ac-ctrl/Medtronic-PB560-Ventilator-System/BOM Drawings/PB560 Ventilator/10040465B00.pdf

PPB560 Volume and Pressure Tests Manufacturing Test Specification Document Number, 10040465 Rev B

Nellcor Puritan Bennett Ireland Ltd. Confidential | Page 1 of 9

# Manufacturing Test Specification Volume and Pressure Tests

PB560

PB560 Volume and Pressure Tests

Nellcor Puritan Bennett Ireland Ltd. Confidential | Page 2 of 9

## Revision History

Revision | Change Order | Author | Approval by | Approval Date | Summary of Change
X1 | ECO-R178940 | | See Agile | See Agile | Initial Draft Release
A | ECO-R182740 | | See Agile | See Agile | Release to Rev A
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
