ac-ctrl/Medtronic-PB560-Ventilator-System/BOM Drawings/PB560 PowerPack/10106052C00/MOLEX 52207-1960.SLDASM

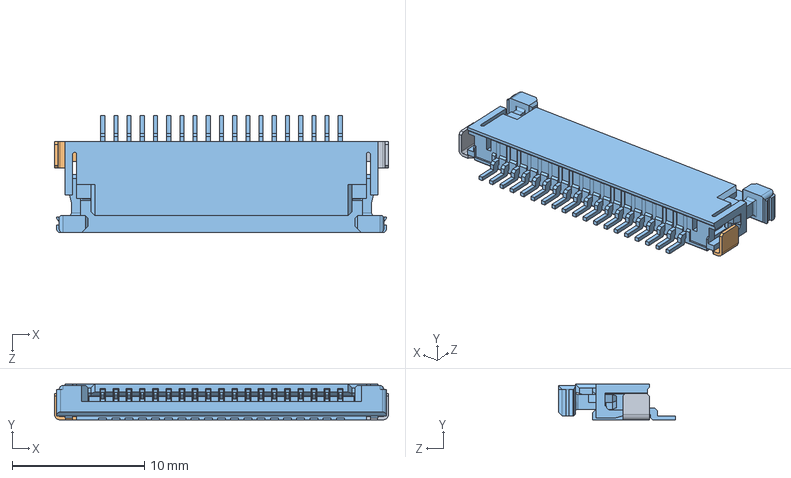
[picture p11: CAD file, 2020-04-08]
BOM Drawings/PB560 PowerPack/10106052C00/MOLEX 52207-1960.SLDASM
25.3 x 2.70 x 8.90 mm
