ac-ctrl/Medtronic-PB560-Ventilator-System/3D CAD Models/alimentation xp.sldasm

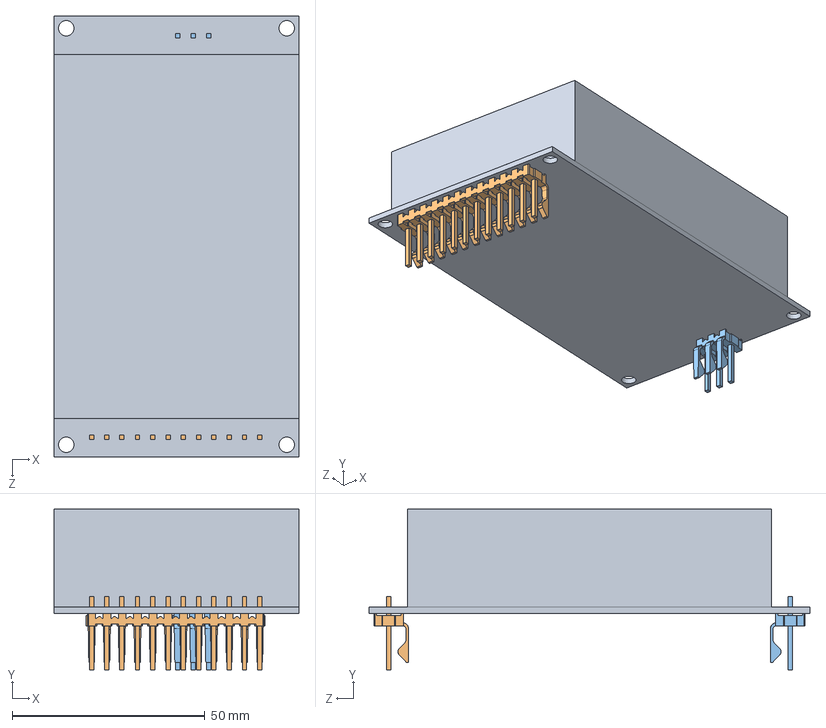
[picture p12: CAD file, 2020-03-31]
3D CAD Models/alimentation xp.sldasm
63.5 x 41.7 x 114.3 mm
alimentation phase 2
