ac-ctrl/Medtronic-PB560-Ventilator-System/3D CAD Models/Batt PCB Assy.SLDASM

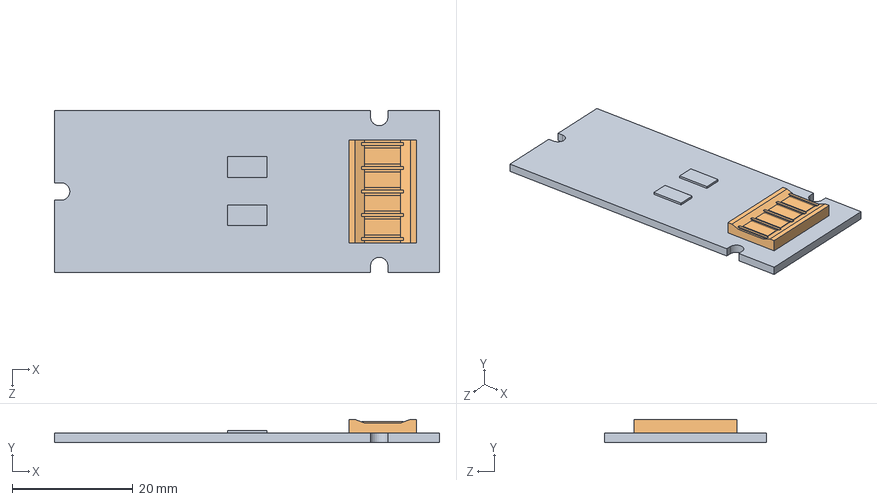
[picture p13: CAD file, 2020-03-31]
3D CAD Models/Batt PCB Assy.SLDASM
63.9 x 3.85 x 26.9 mm
Batt PCB
Batt Contacts tab
