ac-ctrl/Medtronic-PB560-Ventilator-System/3D CAD Models/valve chiprop.SLDASM

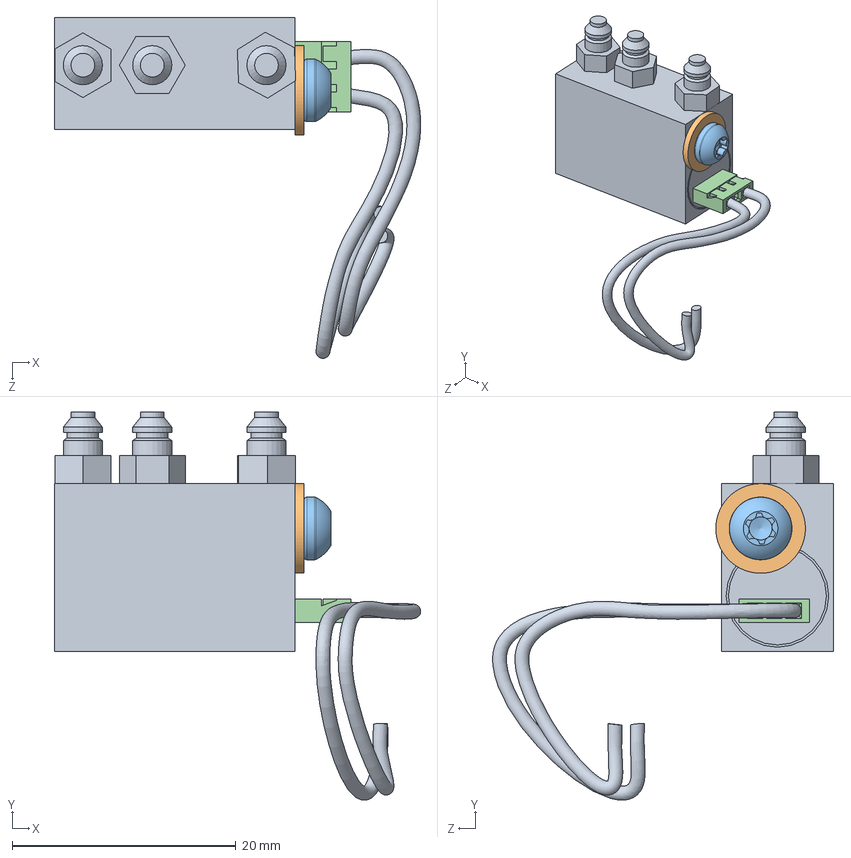
[picture p14: CAD file, 2020-03-31]
3D CAD Models/valve chiprop.SLDASM
32.7 x 34.7 x 30.4 mm
valve chiprop
2004200 Rondelle plate - MN INOX 3 x 8 EP 0.8
2966100 Vis TCB M3 x 5 exalobes acier zingué
Exh Valve connector
