ac-ctrl/Medtronic-PB560-Ventilator-System/3D CAD Models/Batt Assy.SLDASM

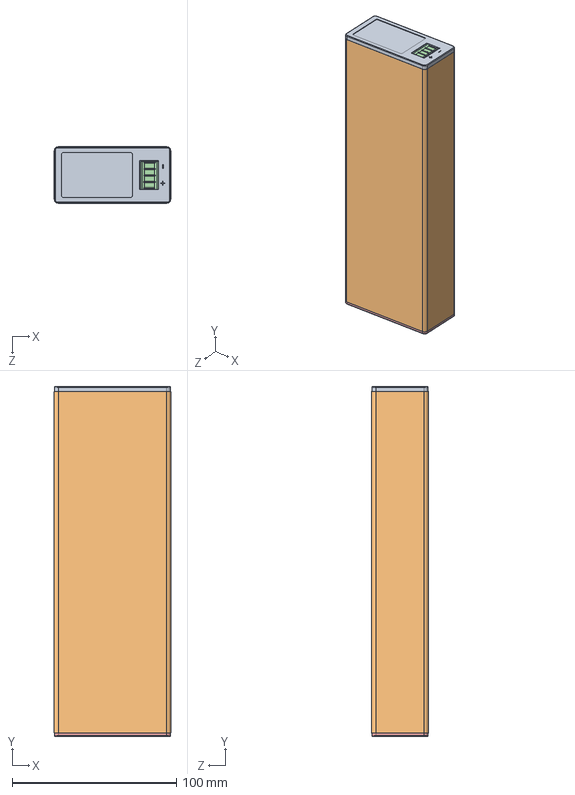
[picture p15: CAD file, 2020-03-31]
3D CAD Models/Batt Assy.SLDASM
71.0 x 213.0 x 34.5 mm
Front End Cap
Extruded housing
Batt PCB
Batt Contacts tab
Back End Cap
