ac-ctrl/Medtronic-PB560-Ventilator-System/3D CAD Models/tuyau 15x21 silicone.SLDPRT

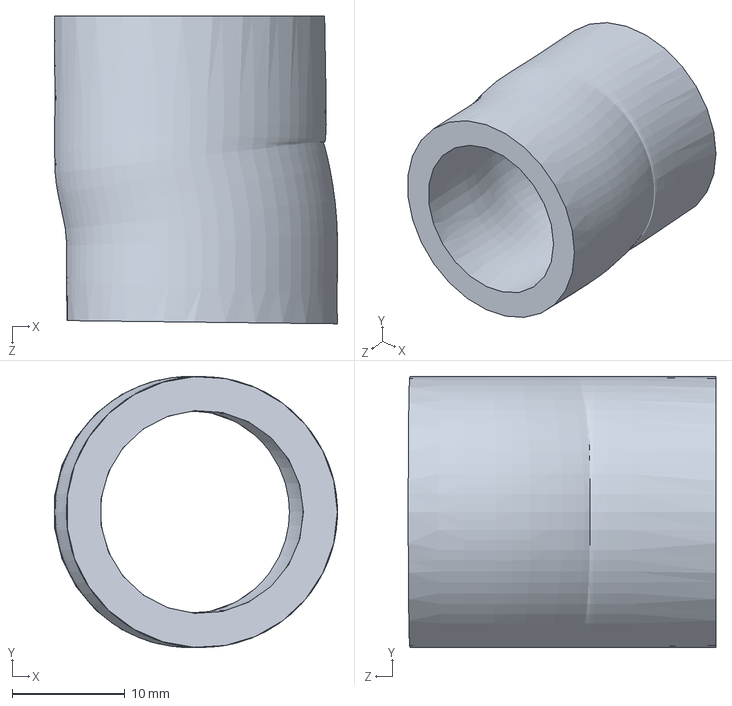
[picture p16: CAD file, 2020-03-31]
3D CAD Models/tuyau 15x21 silicone.SLDPRT
25.1 x 24.0 x 27.2 mm
