ac-ctrl/Medtronic-PB560-Ventilator-System/BOM Drawings/PB560 PowerPack/10109799A00/2-520129-2.SLDPRT

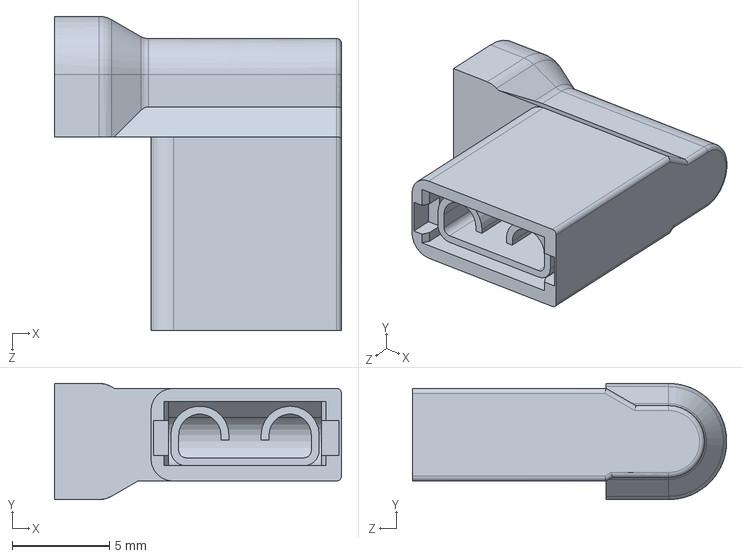
[picture p17: CAD file, 2020-04-08]
BOM Drawings/PB560 PowerPack/10109799A00/2-520129-2.SLDPRT
14.7 x 5.97 x 16.1 mm
