ac-ctrl/Medtronic-PB560-Ventilator-System/BOM Drawings/PB560 PowerPack/10109800A00/TE 62109-2.SLDPRT

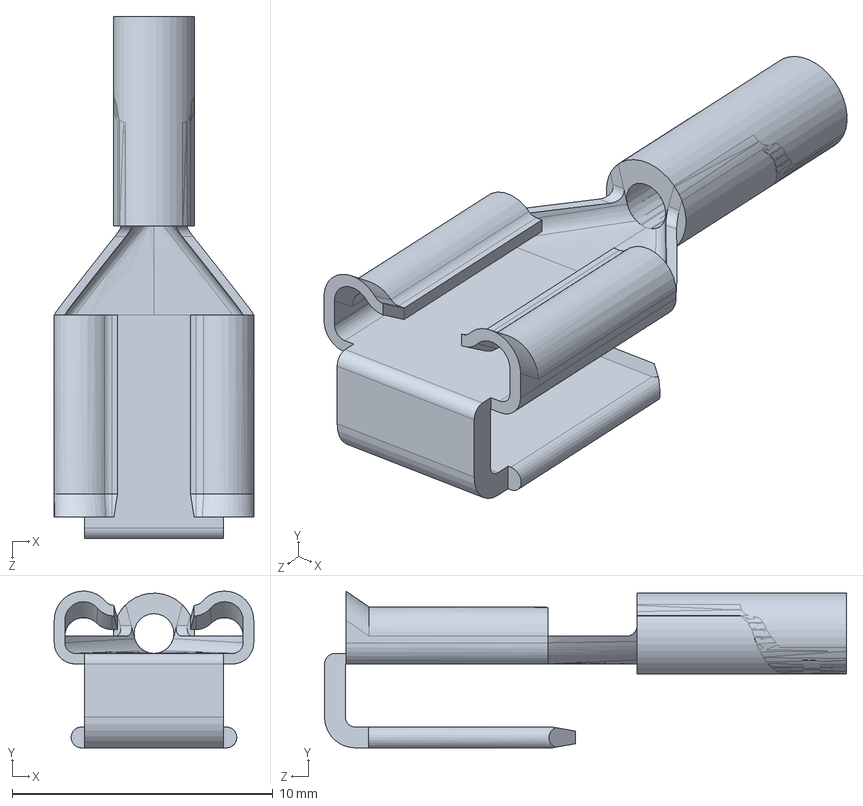
[picture p18: CAD file, 2020-04-08]
BOM Drawings/PB560 PowerPack/10109800A00/TE 62109-2.SLDPRT
7.65 x 6.01 x 20.0 mm
