ac-ctrl/Medtronic-PB560-Ventilator-System/BOM Drawings/PB560 PowerPack/10109802B00/Switchcraft 761KS15 Terminals.SLDPRT

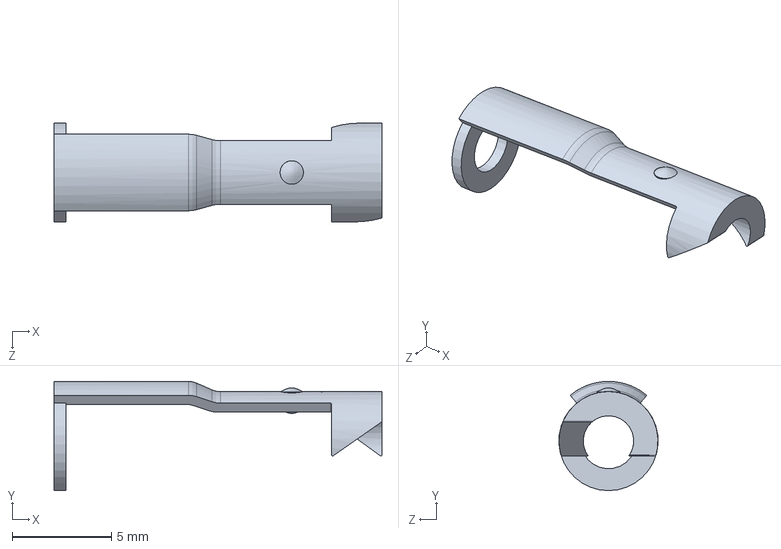
[picture p19: CAD file, 2020-04-08]
BOM Drawings/PB560 PowerPack/10109802B00/Switchcraft 761KS15 Terminals.SLDPRT
16.5 x 5.50 x 4.99 mm
