ac-ctrl/Medtronic-PB560-Ventilator-System/BOM Drawings/PB560 PowerPack/10109797A00/HS Label.SLDPRT

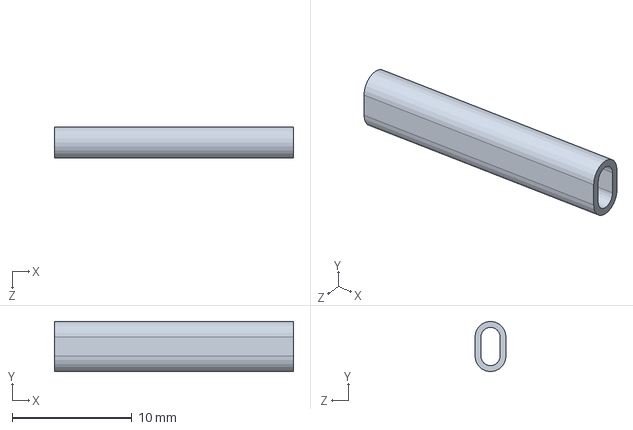
[picture p21: CAD file, 2020-04-08]
BOM Drawings/PB560 PowerPack/10109797A00/HS Label.SLDPRT
20.0 x 4.20 x 2.60 mm
