ac-ctrl/Medtronic-PB560-Ventilator-System/BOM Drawings/PB560 PowerPack/10109801A00/Socket_Switchcraft L712AS.SLDPRT

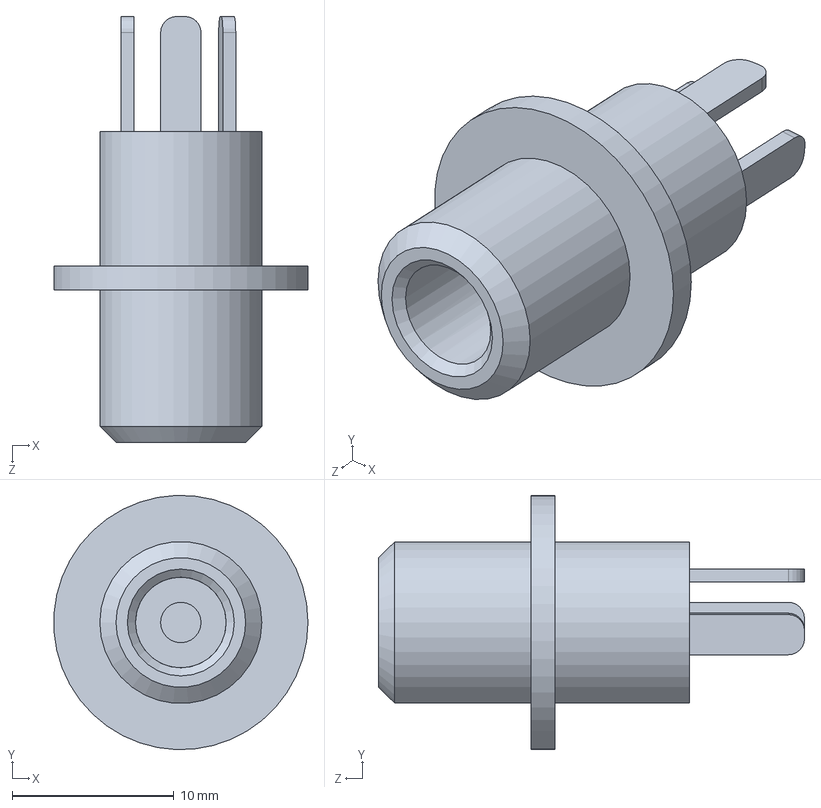
[picture p22: CAD file, 2020-04-08]
BOM Drawings/PB560 PowerPack/10109801A00/Socket_Switchcraft L712AS.SLDPRT
15.7 x 15.7 x 26.3 mm
