ac-ctrl/Medtronic-PB560-Ventilator-System/BOM Drawings/PB560 PowerPack/10113688A00/2-520336-2.SLDPRT

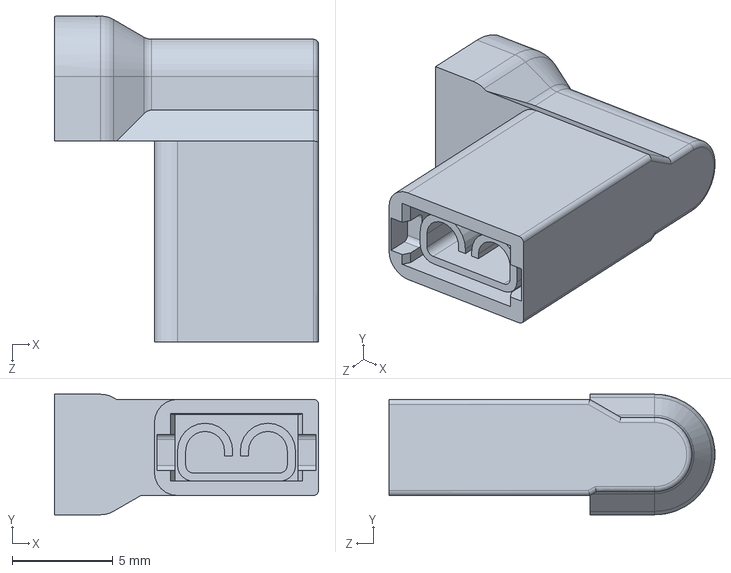
[picture p23: CAD file, 2020-04-08]
BOM Drawings/PB560 PowerPack/10113688A00/2-520336-2.SLDPRT
13.1 x 5.97 x 16.1 mm
