ac-ctrl/Medtronic-PB560-Ventilator-System/BOM Drawings/PB560 Ventilator/10096510/10096506/10096506A00/10096506A00/per.dxf

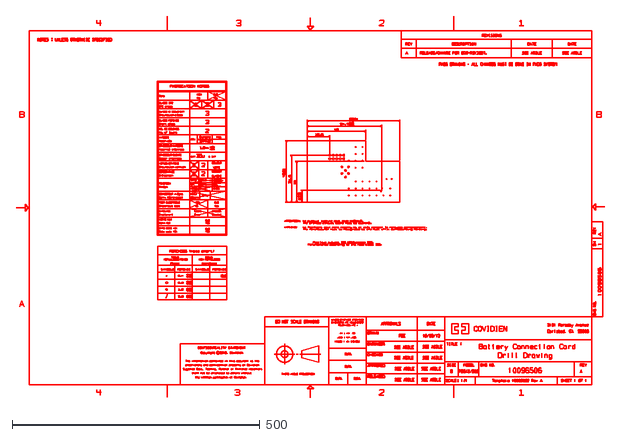
[picture p24: CAD file, 2020-04-08]
BOM Drawings/PB560 Ventilator/10096510/10096506/10096506A00/10096506A00/per.dxf
1188.1 x 770.1
