ac-ctrl/Medtronic-PB560-Ventilator-System/3D CAD Models/entretoise hexa  m3x8.SLDPRT

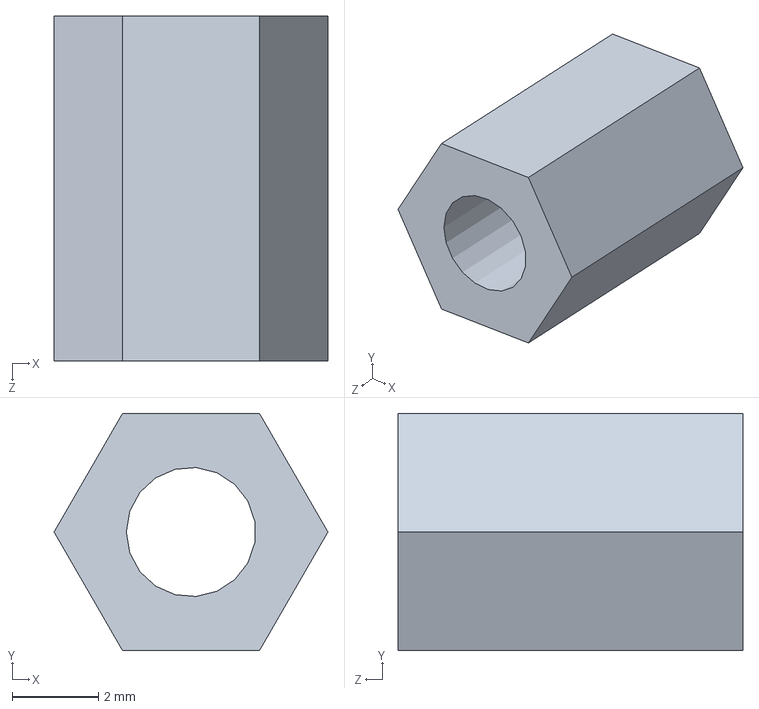
[picture p25: CAD file, 2020-03-31]
3D CAD Models/entretoise hexa m3x8.SLDPRT
6.35 x 5.50 x 8.00 mm
