ac-ctrl/Medtronic-PB560-Ventilator-System/3D CAD Models/39-28-5264.SLDPRT

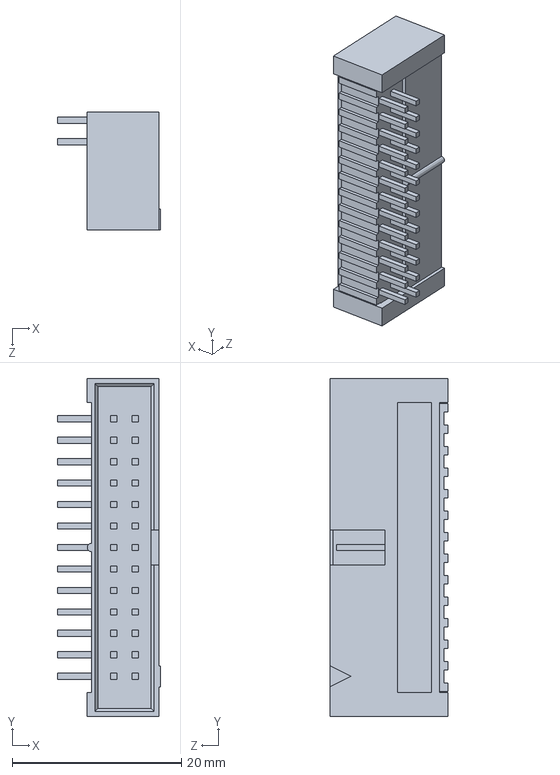
[picture p27: CAD file, 2020-03-31]
3D CAD Models/39-28-5264.SLDPRT
12.1 x 40.0 x 14.0 mm
