ac-ctrl/Medtronic-PB560-Ventilator-System/BOM Drawings/PB560 PowerPack/10106052C00/MOLEX 43650-0229.SLDPRT

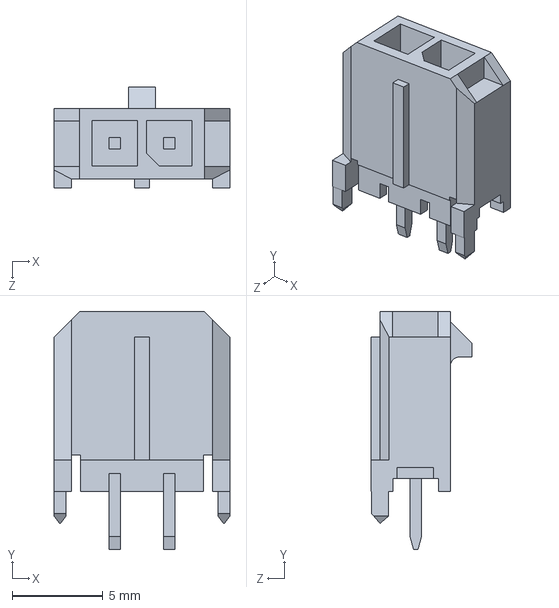
[picture p28: CAD file, 2020-04-08]
BOM Drawings/PB560 PowerPack/10106052C00/MOLEX 43650-0229.SLDPRT
9.65 x 13.1 x 5.57 mm
