ac-ctrl/Medtronic-PB560-Ventilator-System/BOM Drawings/PB560 PowerPack/10109802B00/WURTH 74270057.SLDPRT

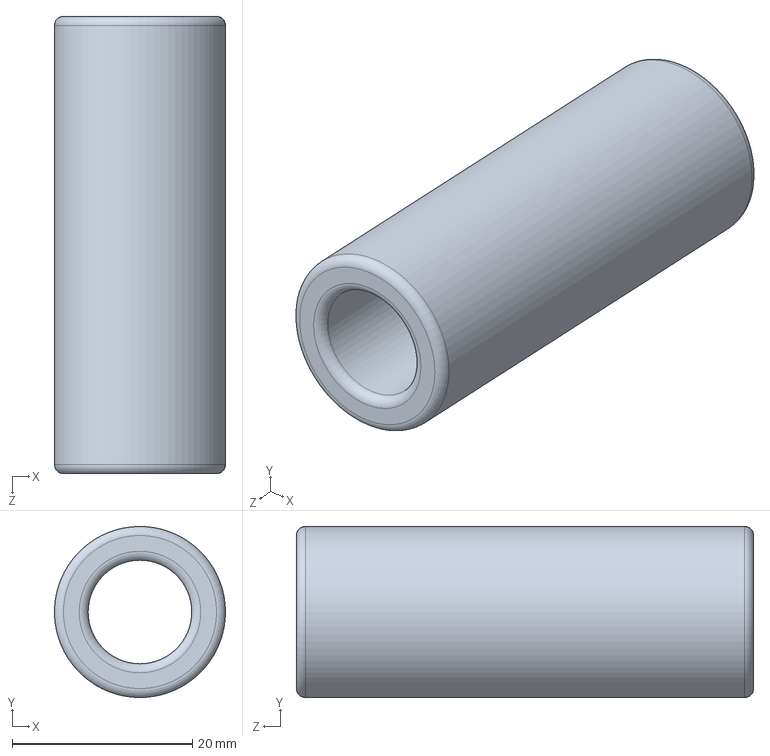
[picture p29: CAD file, 2020-04-08]
BOM Drawings/PB560 PowerPack/10109802B00/WURTH 74270057.SLDPRT
19.0 x 19.0 x 50.8 mm
