ac-ctrl/Medtronic-PB560-Ventilator-System/BOM Drawings/PB560 PowerPack/10110230A00 (1)/KerbKonus_307000030100.SLDPRT

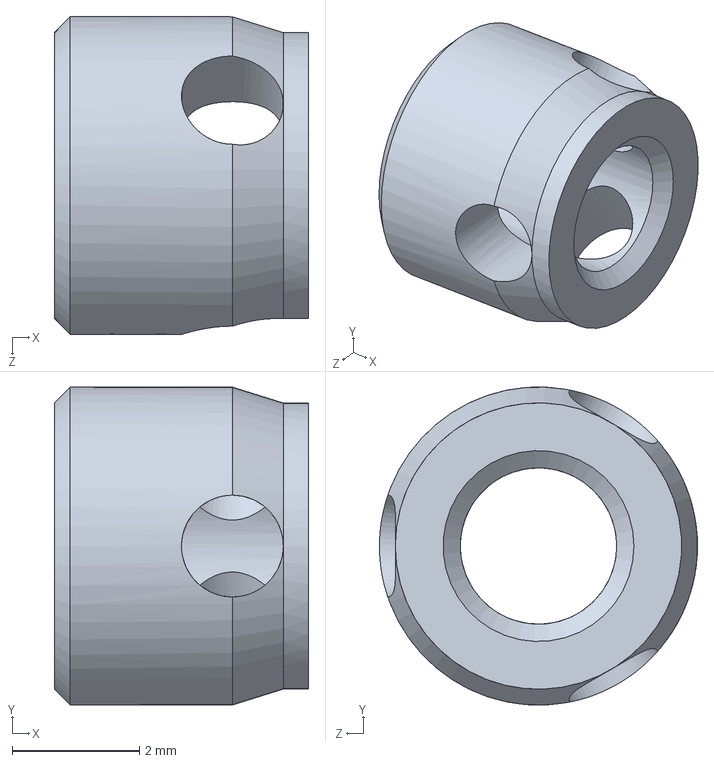
[picture p30: CAD file, 2020-04-08]
BOM Drawings/PB560 PowerPack/10110230A00 (1)/KerbKonus_307000030100.SLDPRT
4.00 x 5.00 x 5.00 mm
