ac-ctrl/Medtronic-PB560-Ventilator-System/3D CAD Models/PRECI-DIP 811-S1-002-30-014101.SLDPRT

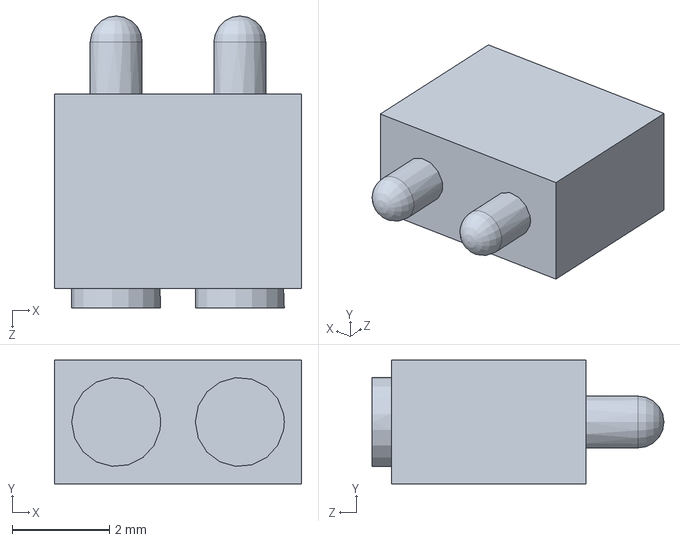
[picture p31: CAD file, 2020-03-31]
3D CAD Models/PRECI-DIP 811-S1-002-30-014101.SLDPRT
5.08 x 2.54 x 6.00 mm
