ac-ctrl/Medtronic-PB560-Ventilator-System/3D CAD Models/Joint blindage conducteur 72x21xép4.SLDPRT

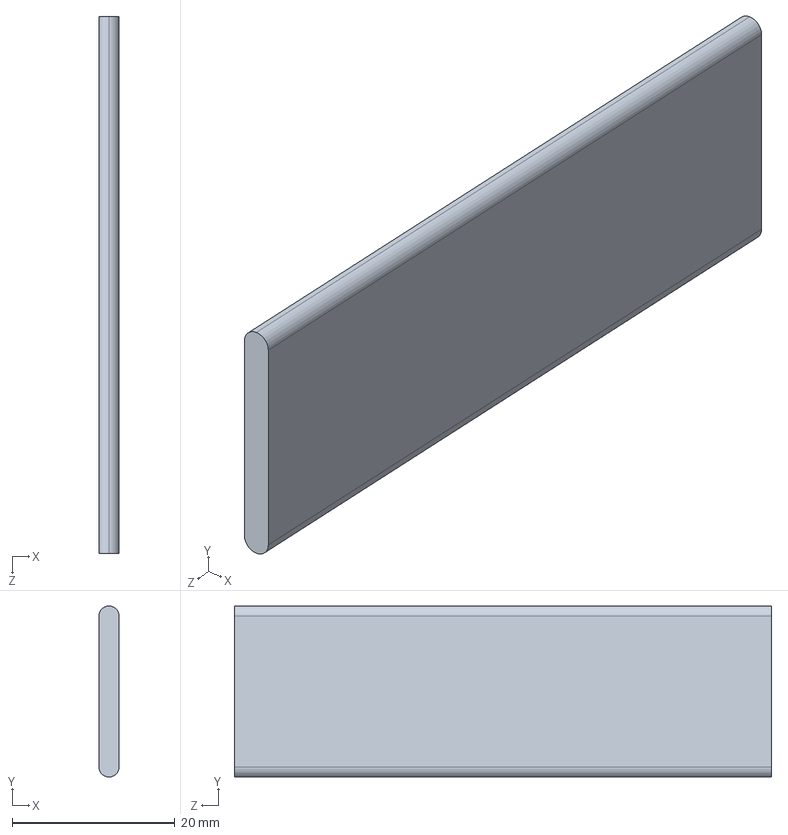
[picture p32: CAD file, 2020-03-31]
3D CAD Models/Joint blindage conducteur 72x21xép4.SLDPRT
2.50 x 21.0 x 66.0 mm
