ac-ctrl/Medtronic-PB560-Ventilator-System/3D CAD Models/HIROSE HR30-6R-6S.SLDPRT

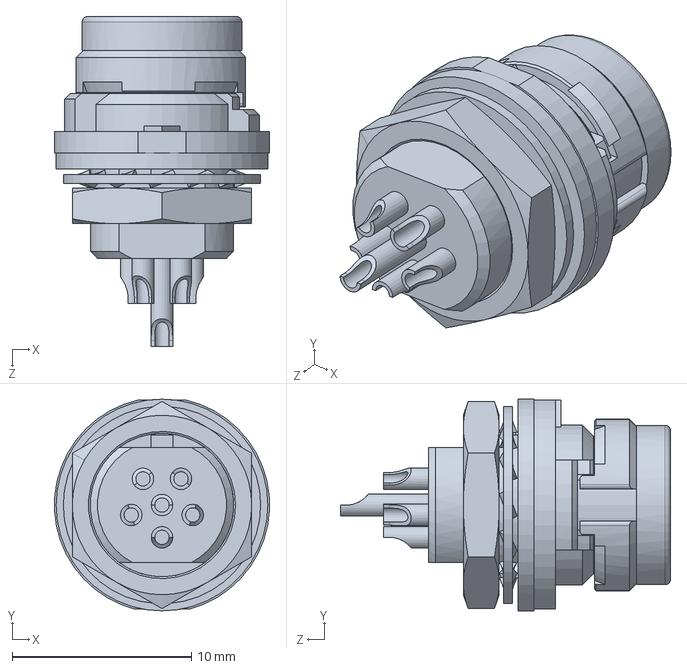
[picture p33: CAD file, 2020-03-31]
3D CAD Models/HIROSE HR30-6R-6S.SLDPRT
12.0 x 11.8 x 18.4 mm
