ac-ctrl/Medtronic-PB560-Ventilator-System/3D CAD Models/702-09 Entretoise AV Legendair.SLDPRT

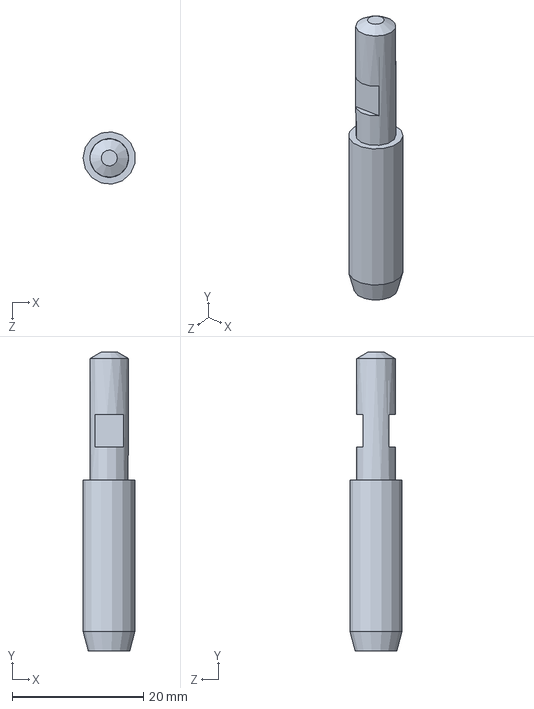
[picture p34: CAD file, 2020-03-31]
3D CAD Models/702-09 Entretoise AV Legendair.SLDPRT
7.91 x 45.5 x 7.96 mm
