ac-ctrl/Medtronic-PB560-Ventilator-System/3D CAD Models/1mm bumper.SLDPRT

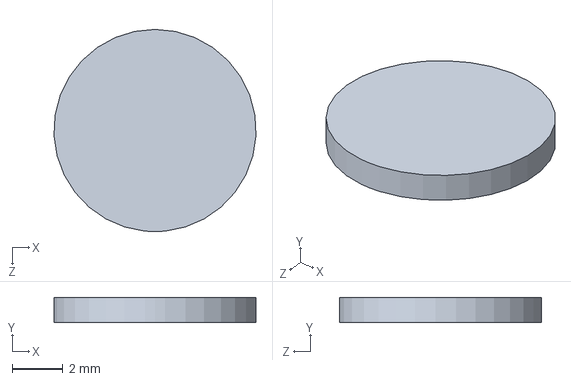
[picture p35: CAD file, 2020-03-31]
3D CAD Models/1mm bumper.SLDPRT
7.99 x 1.00 x 8.00 mm
