ac-ctrl/Medtronic-PB560-Ventilator-System/3D CAD Models/carte buzzer.SLDPRT

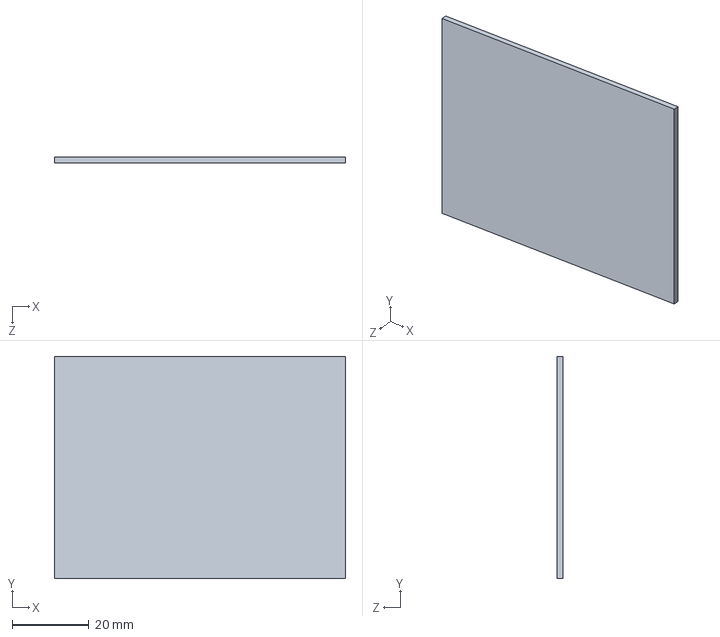
[picture p36: CAD file, 2020-03-31]
3D CAD Models/carte buzzer.SLDPRT
76.0 x 58.0 x 1.60 mm
