ac-ctrl/Medtronic-PB560-Ventilator-System/BOM Drawings/PB560 PowerPack/10106052C00/JST S2B-ZR-SM4A-TF.SLDPRT

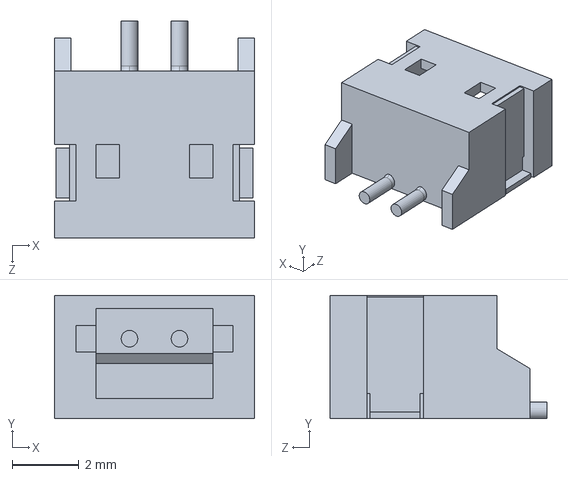
[picture p37: CAD file, 2020-04-08]
BOM Drawings/PB560 PowerPack/10106052C00/JST S2B-ZR-SM4A-TF.SLDPRT
6.00 x 3.70 x 6.50 mm
