ac-ctrl/Medtronic-PB560-Ventilator-System/BOM Drawings/PB560 PowerPack/10106052C00/MOLEX 02661-4020.SLDPRT

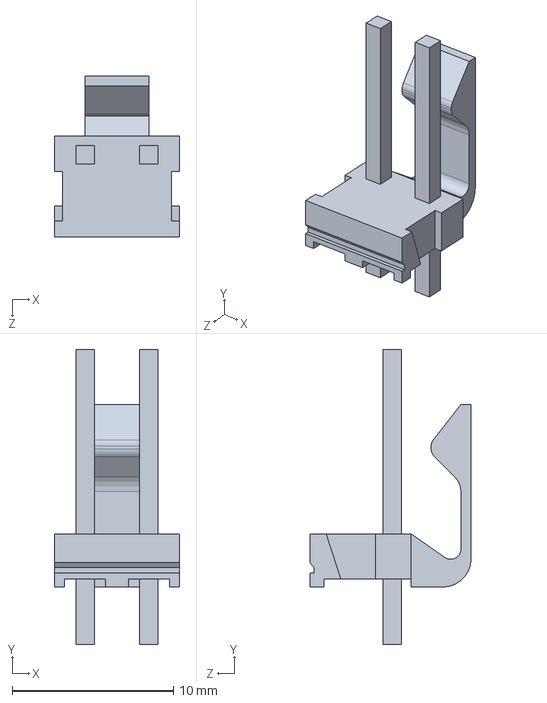
[picture p39: CAD file, 2020-04-08]
BOM Drawings/PB560 PowerPack/10106052C00/MOLEX 02661-4020.SLDPRT
7.77 x 18.3 x 10.0 mm
