ac-ctrl/Medtronic-PB560-Ventilator-System/BOM Drawings/PB560 PowerPack/10109802B00/Switchcraft 761KS15 Centre pin.SLDPRT

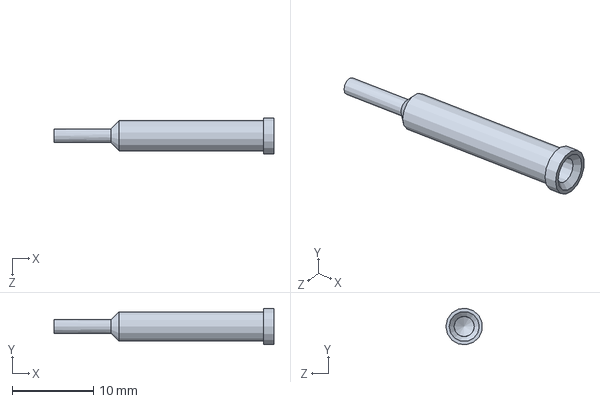
[picture p40: CAD file, 2020-04-08]
BOM Drawings/PB560 PowerPack/10109802B00/Switchcraft 761KS15 Centre pin.SLDPRT
27.0 x 4.48 x 4.45 mm
