ac-ctrl/Medtronic-PB560-Ventilator-System/BOM Drawings/PB560 PowerPack/10109802B00/Switchcraft 761KS15 Terminal spacer.SLDPRT

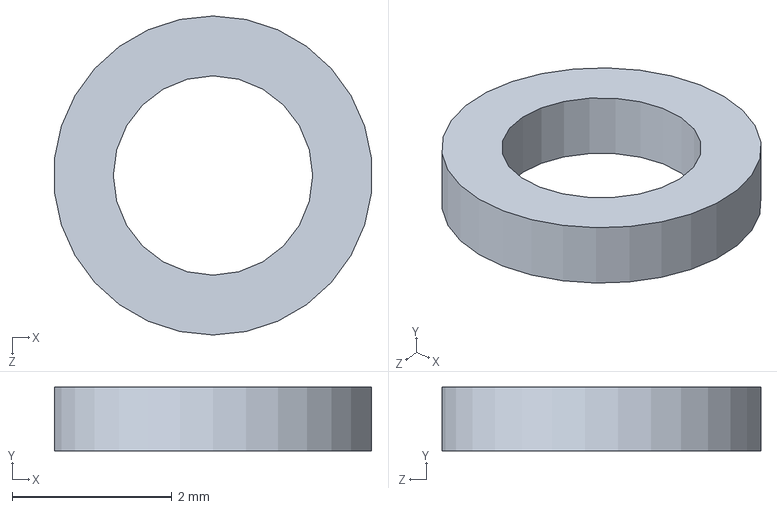
[picture p41: CAD file, 2020-04-08]
BOM Drawings/PB560 PowerPack/10109802B00/Switchcraft 761KS15 Terminal spacer.SLDPRT
3.98 x 0.8 x 4.00 mm
