ac-ctrl/Medtronic-PB560-Ventilator-System/BOM Drawings/PB560 PowerPack/10109802B00/Straight DC OM PLUG_Switchcraft.SLDPRT

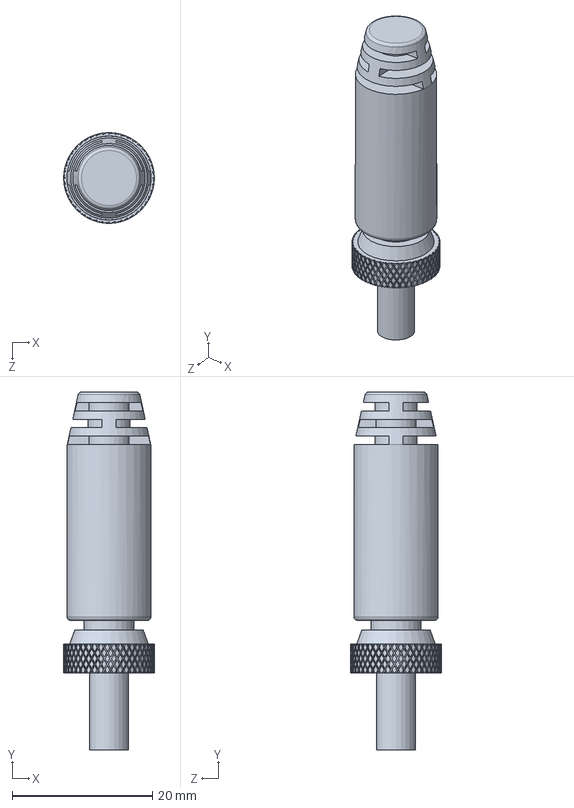
[picture p42: CAD file, 2020-04-08]
BOM Drawings/PB560 PowerPack/10109802B00/Straight DC OM PLUG_Switchcraft.SLDPRT
12.9 x 51.1 x 12.9 mm
