ac-ctrl/Medtronic-PB560-Ventilator-System/3D CAD Models/capteur debit.SLDPRT

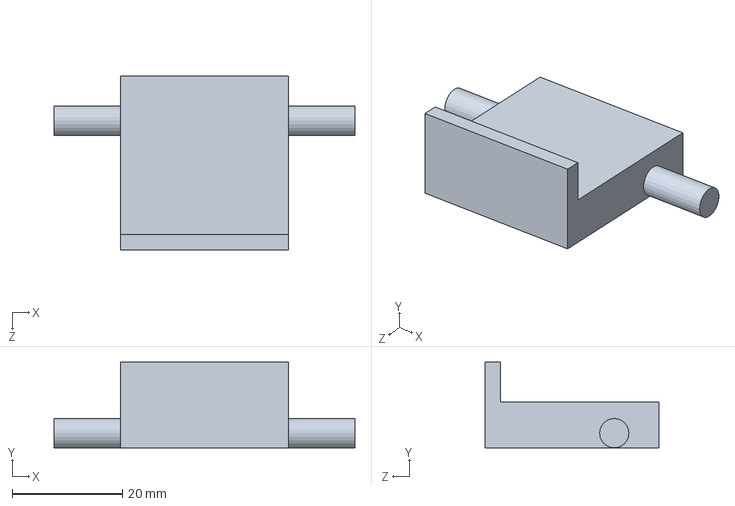
[picture p43: CAD file, 2020-03-31]
3D CAD Models/capteur debit.SLDPRT
54.5 x 15.5 x 31.5 mm
