ac-ctrl/Medtronic-PB560-Ventilator-System/3D CAD Models/Extruded housing.SLDPRT

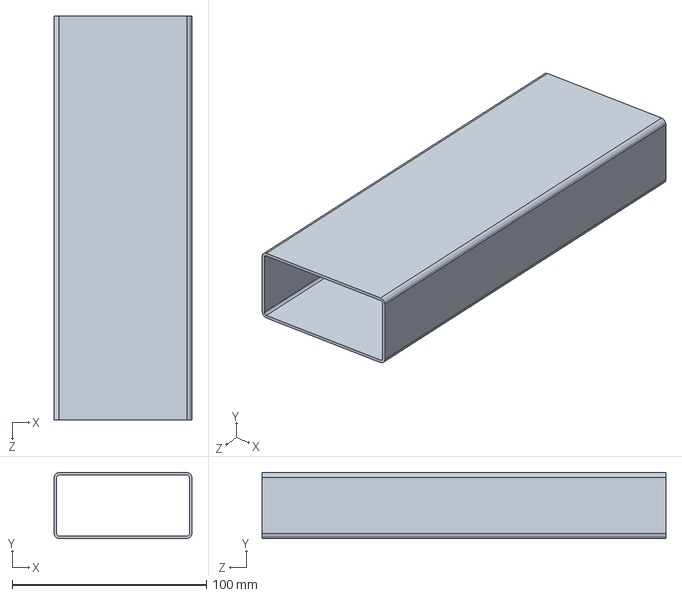
[picture p45: CAD file, 2020-03-31]
3D CAD Models/Extruded housing.SLDPRT
71.0 x 34.0 x 208.0 mm
