ac-ctrl/Medtronic-PB560-Ventilator-System/3D CAD Models/tuyau  droit sortie vanne O2.SLDPRT

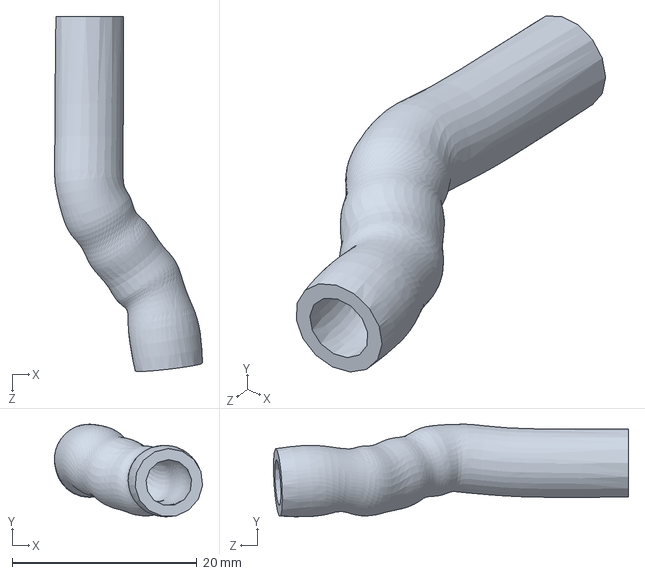
[picture p46: CAD file, 2020-03-31]
3D CAD Models/tuyau droit sortie vanne O2.SLDPRT
16.1 x 10.0 x 38.5 mm
