ac-ctrl/Medtronic-PB560-Ventilator-System/3D CAD Models/MOLEX 43650-0212.SLDPRT

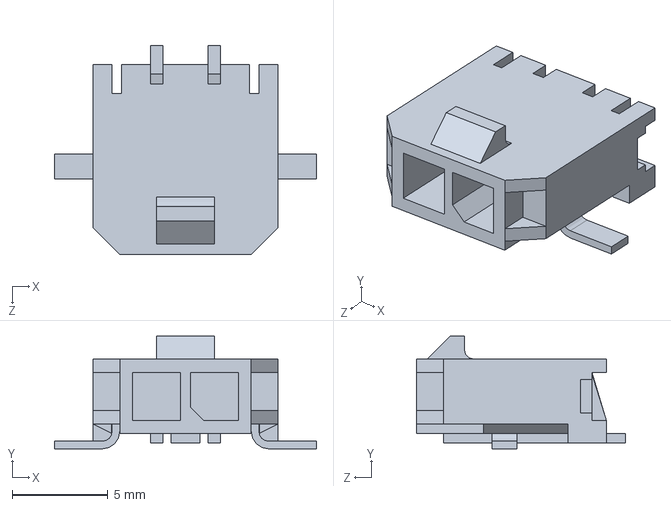
[picture p47: CAD file, 2020-03-31]
3D CAD Models/MOLEX 43650-0212.SLDPRT
13.6 x 5.87 x 10.9 mm
