ac-ctrl/Medtronic-PB560-Ventilator-System/3D CAD Models/feritte nappe afficheur.SLDPRT

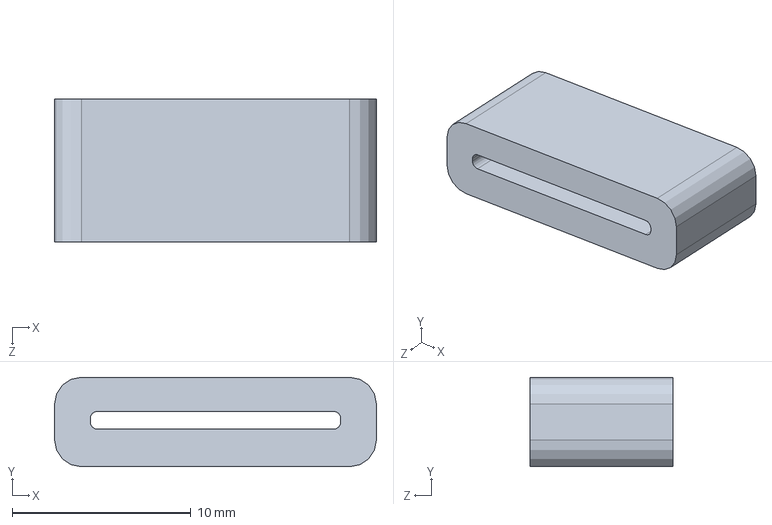
[picture p48: CAD file, 2020-03-31]
3D CAD Models/feritte nappe afficheur.SLDPRT
18.0 x 5.00 x 8.00 mm
