ac-ctrl/Medtronic-PB560-Ventilator-System/3D CAD Models/MOLEX 22-05-7088.SLDPRT

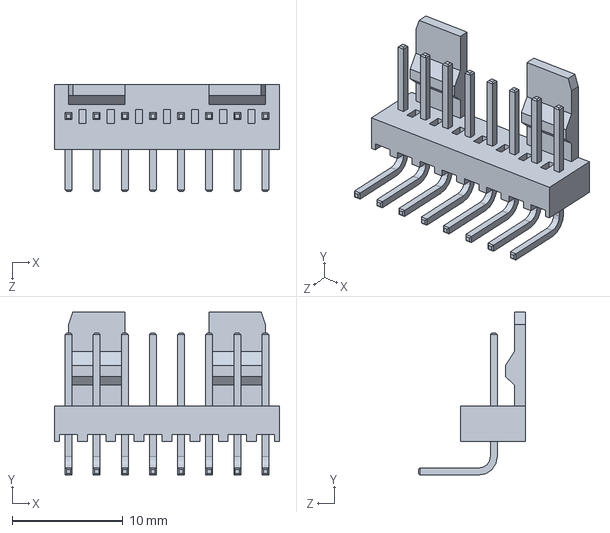
[picture p49: CAD file, 2020-03-31]
3D CAD Models/MOLEX 22-05-7088.SLDPRT
20.3 x 14.7 x 9.65 mm
