ac-ctrl/Medtronic-PB560-Ventilator-System/3D CAD Models/22-05-7028.SLDPRT

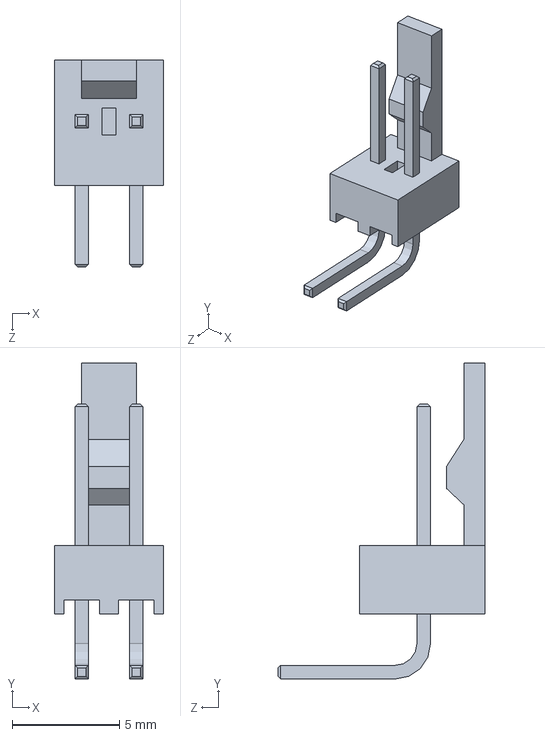
[picture p50: CAD file, 2020-03-31]
3D CAD Models/22-05-7028.SLDPRT
5.08 x 14.7 x 9.65 mm
