ac-ctrl/Medtronic-PB560-Ventilator-System/3D CAD Models/connecteur USB A vertical.SLDPRT

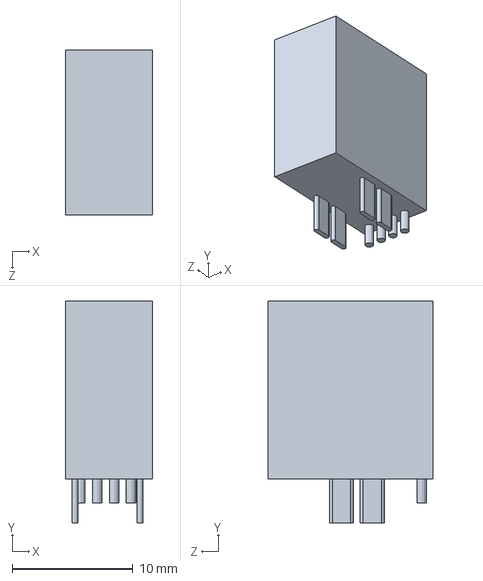
[picture p51: CAD file, 2020-03-31]
3D CAD Models/connecteur USB A vertical.SLDPRT
7.25 x 18.4 x 13.7 mm
