ac-ctrl/Medtronic-PB560-Ventilator-System/3D CAD Models/Molex 90635-1262.SLDPRT

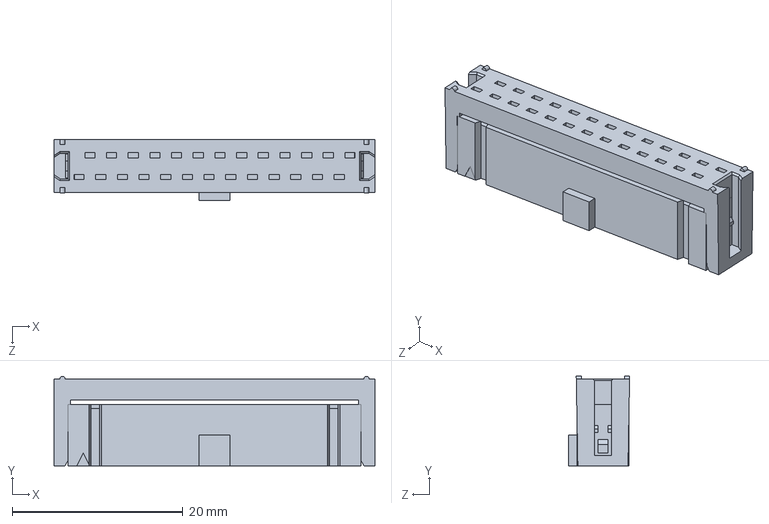
[picture p52: CAD file, 2020-03-31]
3D CAD Models/Molex 90635-1262.SLDPRT
37.6 x 10.5 x 7.18 mm
