ac-ctrl/Medtronic-PB560-Ventilator-System/3D CAD Models/3M 7810-0000PR.SLDPRT

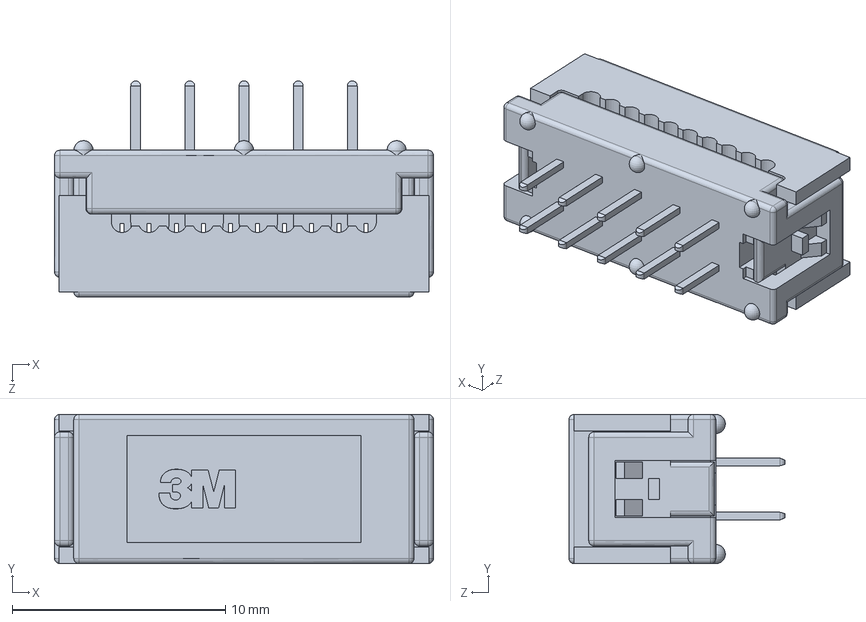
[picture p53: CAD file, 2020-03-31]
3D CAD Models/3M 7810-0000PR.SLDPRT
17.8 x 7.00 x 10.1 mm
