ac-ctrl/Medtronic-PB560-Ventilator-System/3D CAD Models/Batt PCB.SLDPRT

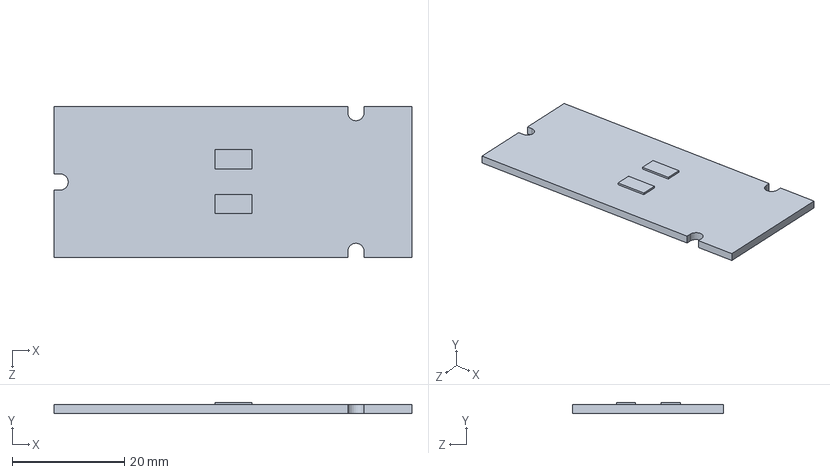
[picture p54: CAD file, 2020-03-31]
3D CAD Models/Batt PCB.SLDPRT
63.9 x 2.00 x 26.9 mm
