ac-ctrl/Medtronic-PB560-Ventilator-System/3D CAD Models/transfo.SLDPRT

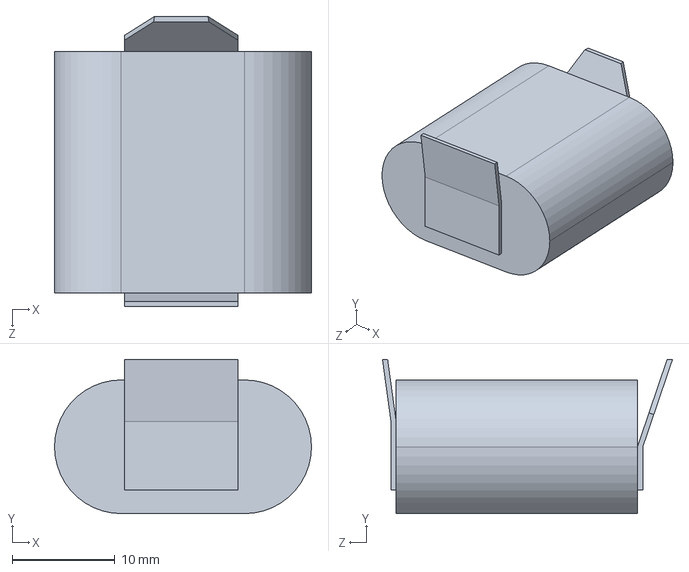
[picture p55: CAD file, 2020-03-31]
3D CAD Models/transfo.SLDPRT
25.0 x 15.0 x 28.2 mm
