ac-ctrl/Medtronic-PB560-Ventilator-System/3D CAD Models/HIROSE HR25A-7R-8S.SLDPRT

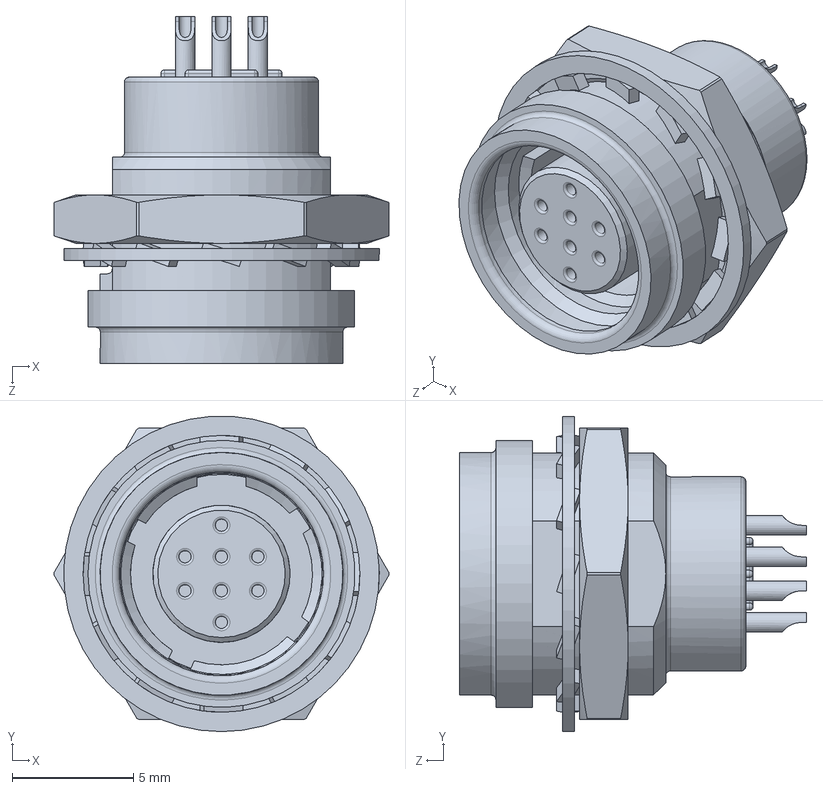
[picture p56: CAD file, 2020-03-31]
3D CAD Models/HIROSE HR25A-7R-8S.SLDPRT
13.8 x 13.0 x 14.3 mm
