ac-ctrl/Medtronic-PB560-Ventilator-System/3D CAD Models/Vis KA22x5 hexalobes.SLDPRT

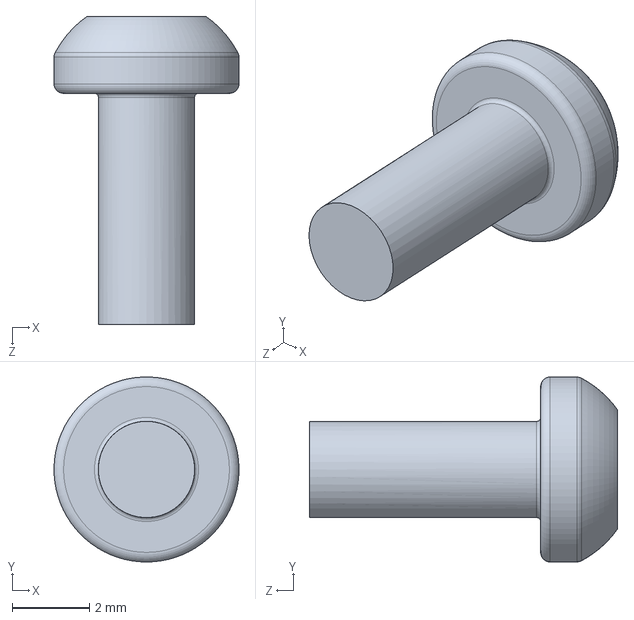
[picture p57: CAD file, 2020-03-31]
3D CAD Models/Vis KA22x5 hexalobes.SLDPRT
4.80 x 4.80 x 8.00 mm
