ac-ctrl/Medtronic-PB560-Ventilator-System/3D CAD Models/I0 178 Entretoise AR Legendair.SLDPRT

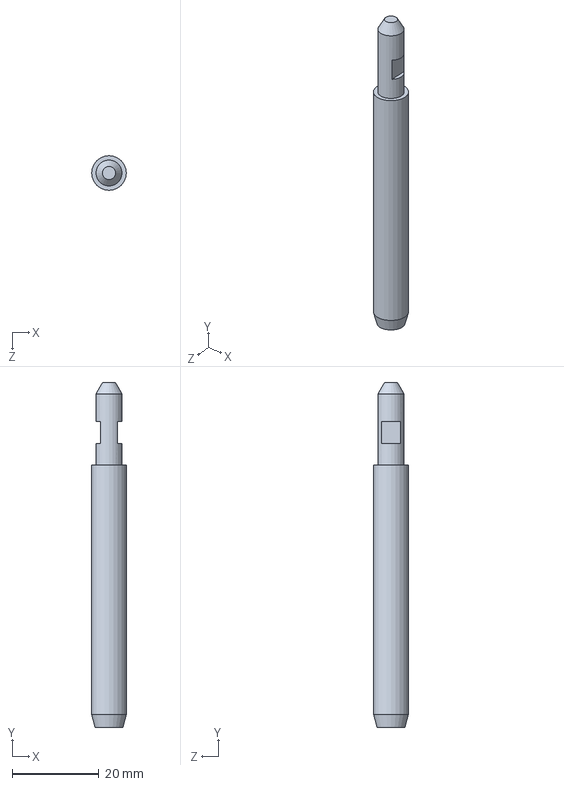
[picture p58: CAD file, 2020-03-31]
3D CAD Models/I0 178 Entretoise AR Legendair.SLDPRT
8.00 x 79.5 x 8.00 mm
