ac-ctrl/Medtronic-PB560-Ventilator-System/3D CAD Models/Front End Cap.SLDPRT

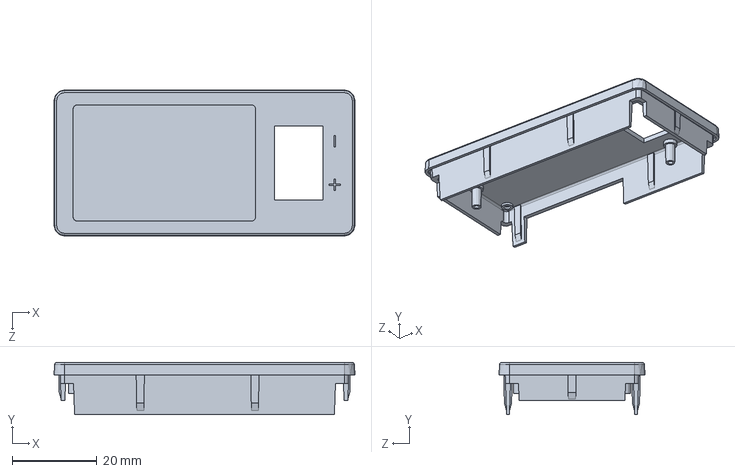
[picture p59: CAD file, 2020-03-31]
3D CAD Models/Front End Cap.SLDPRT
70.9 x 12.3 x 34.4 mm
