ac-ctrl/Medtronic-PB560-Ventilator-System/3D CAD Models/tuyau débit inspi P1.SLDPRT

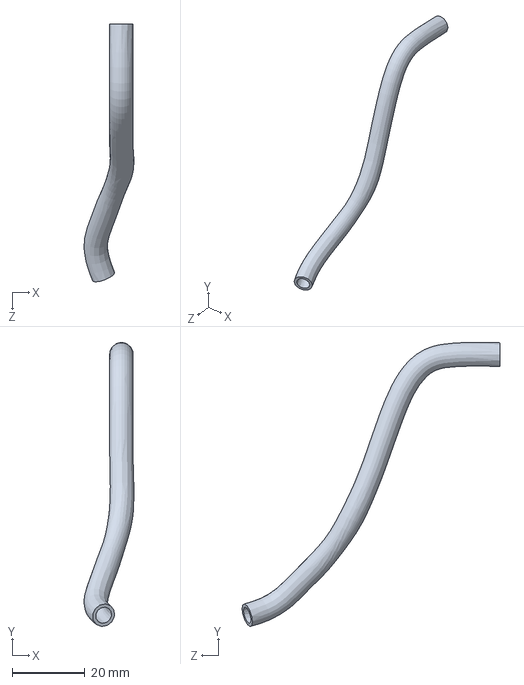
[picture p60: CAD file, 2020-03-31]
3D CAD Models/tuyau débit inspi P1.SLDPRT
13.7 x 78.2 x 71.1 mm
