ac-ctrl/Medtronic-PB560-Ventilator-System/3D CAD Models/condensateur.SLDPRT

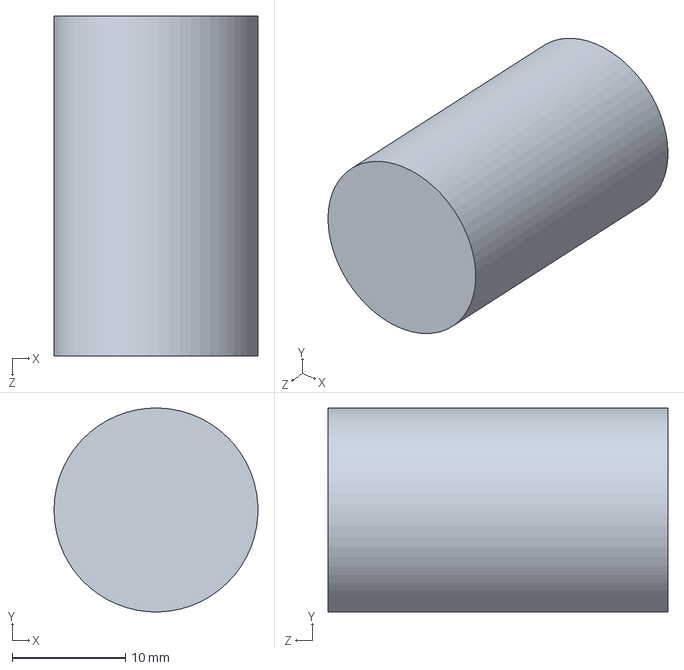
[picture p61: CAD file, 2020-03-31]
3D CAD Models/condensateur.SLDPRT
18.0 x 18.0 x 30.0 mm
