ac-ctrl/Medtronic-PB560-Ventilator-System/3D CAD Models/new circuit support alimentation avec usb.SLDPRT

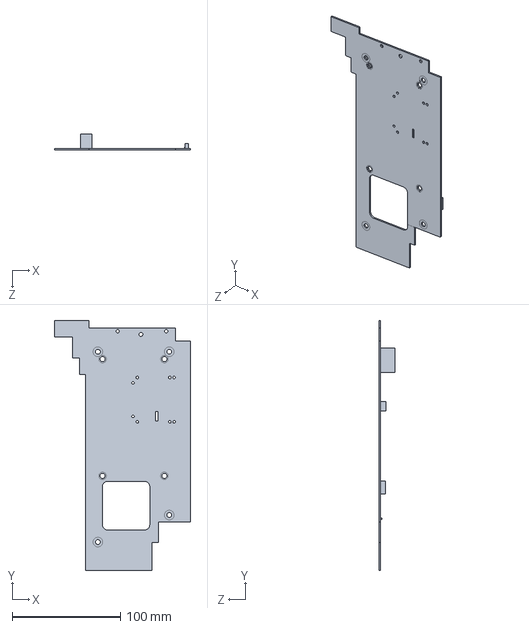
[picture p62: CAD file, 2020-03-31]
3D CAD Models/new circuit support alimentation avec usb.SLDPRT
125.9 x 231.2 x 14.8 mm
