ac-ctrl/Medtronic-PB560-Ventilator-System/3D CAD Models/regulateur.SLDPRT

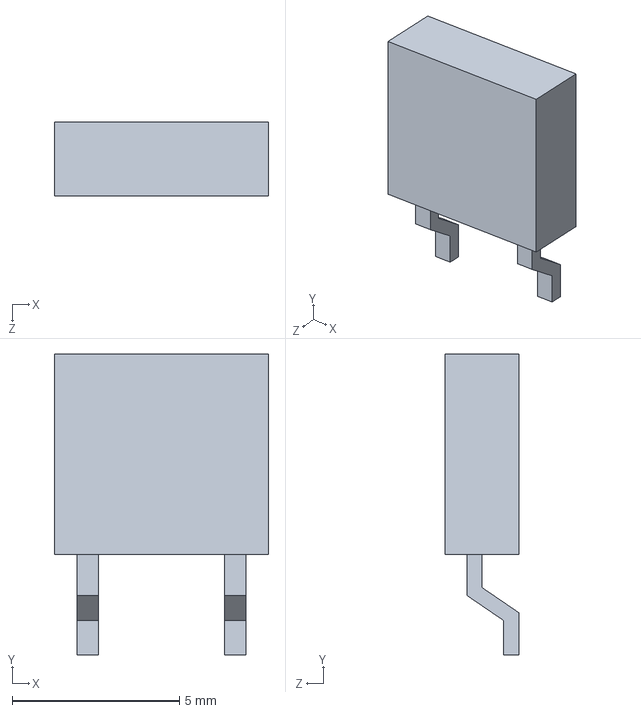
[picture p63: CAD file, 2020-03-31]
3D CAD Models/regulateur.SLDPRT
6.40 x 9.00 x 2.20 mm
