ac-ctrl/Medtronic-PB560-Ventilator-System/3D CAD Models/tuyau pression interne1.6x4.8.SLDPRT

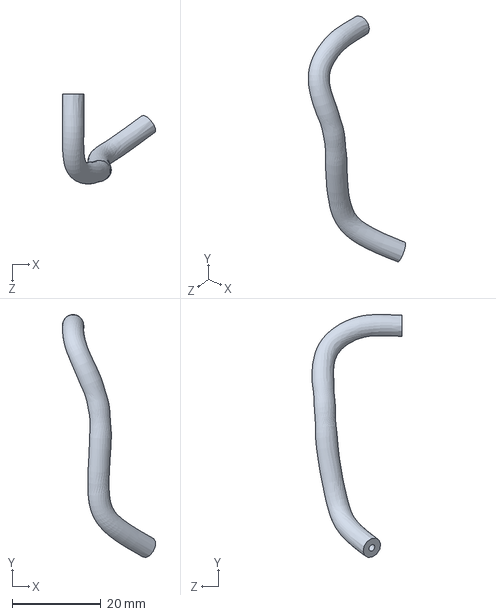
[picture p64: CAD file, 2020-03-31]
3D CAD Models/tuyau pression interne1.6x4.8.SLDPRT
21.0 x 54.7 x 20.3 mm
