ac-ctrl/Medtronic-PB560-Ventilator-System/3D CAD Models/boitier capteur pression asdx.SLDPRT

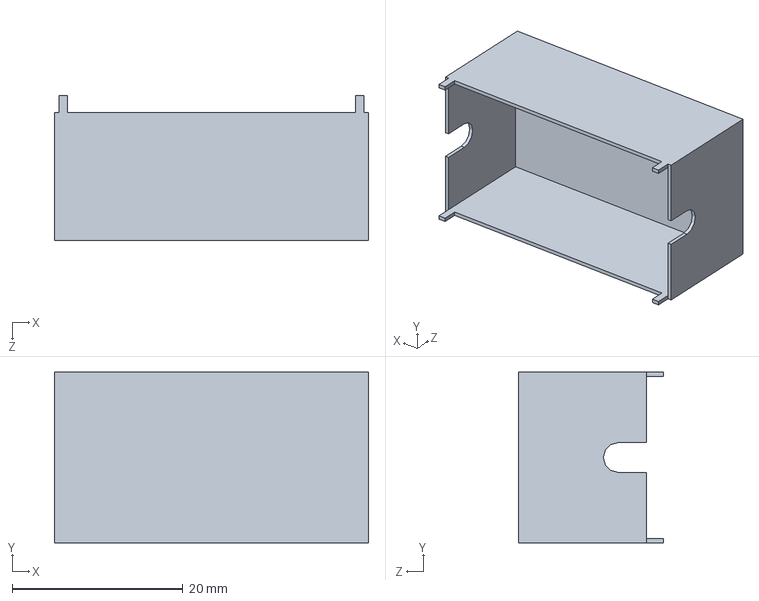
[picture p65: CAD file, 2020-03-31]
3D CAD Models/boitier capteur pression asdx.SLDPRT
36.8 x 20.0 x 17.0 mm
