ac-ctrl/Medtronic-PB560-Ventilator-System/3D CAD Models/tuyau débit inspi P2.SLDPRT

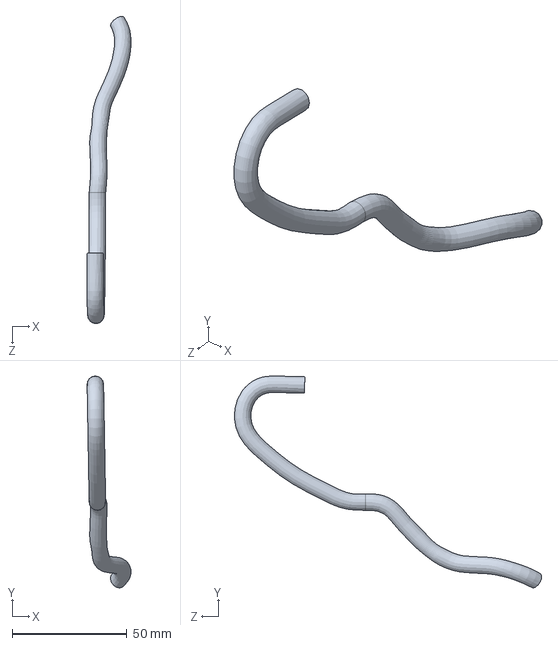
[picture p66: CAD file, 2020-03-31]
3D CAD Models/tuyau débit inspi P2.SLDPRT
19.1 x 92.3 x 133.7 mm
