ac-ctrl/Medtronic-PB560-Ventilator-System/3D CAD Models/buzzer1.SLDPRT

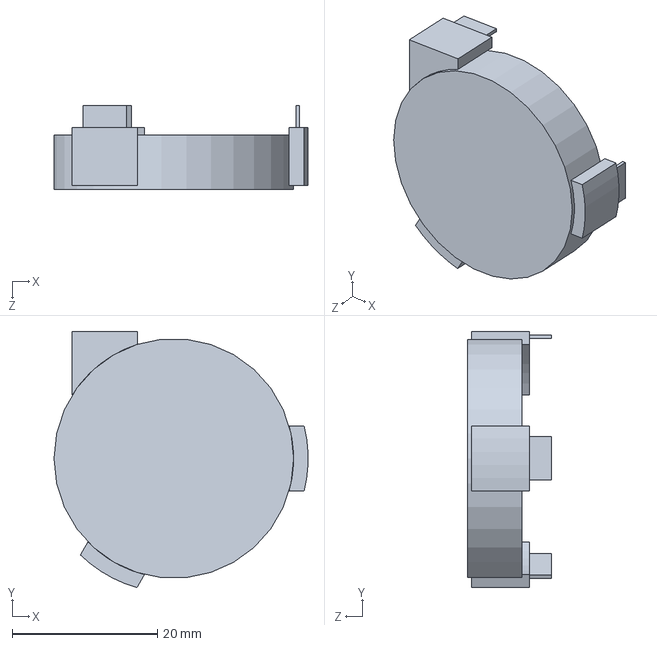
[picture p67: CAD file, 2020-03-31]
3D CAD Models/buzzer1.SLDPRT
35.0 x 35.3 x 11.5 mm
