ac-ctrl/Medtronic-PB560-Ventilator-System/3D CAD Models/connecteur USB miniB.SLDPRT

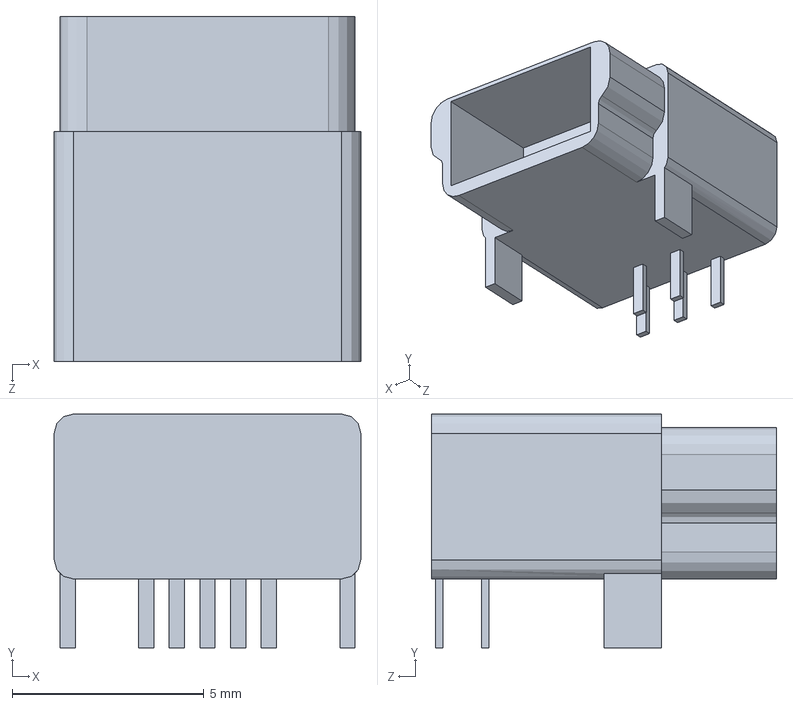
[picture p68: CAD file, 2020-03-31]
3D CAD Models/connecteur USB miniB.SLDPRT
8.00 x 6.10 x 9.00 mm
