ac-ctrl/Medtronic-PB560-Ventilator-System/3D CAD Models/isolant adhésif capot capteur.SLDPRT

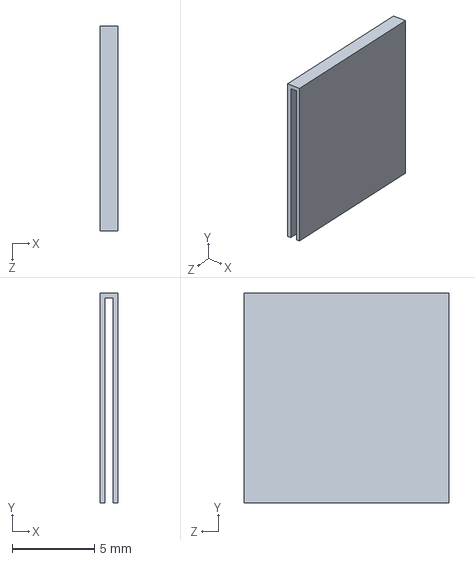
[picture p69: CAD file, 2020-03-31]
3D CAD Models/isolant adhésif capot capteur.SLDPRT
1.10 x 12.8 x 12.5 mm
