ac-ctrl/Medtronic-PB560-Ventilator-System/3D CAD Models/tuyau pression vanne pilot1.6x4.8.SLDPRT

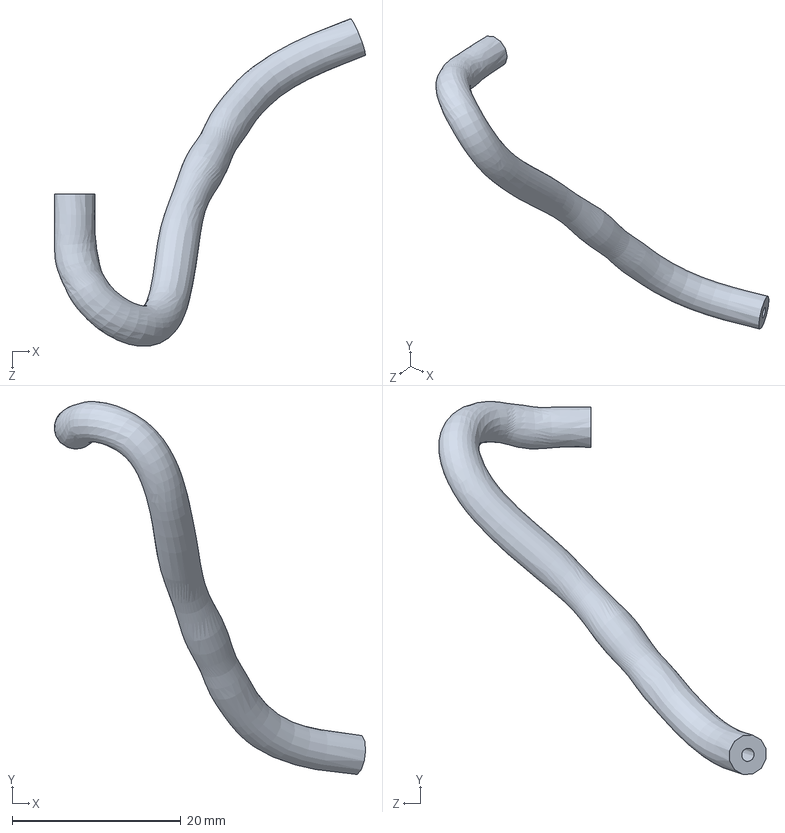
[picture p70: CAD file, 2020-03-31]
3D CAD Models/tuyau pression vanne pilot1.6x4.8.SLDPRT
36.8 x 44.2 x 38.7 mm
