ac-ctrl/Medtronic-PB560-Ventilator-System/3D CAD Models/carte clairitec.SLDPRT

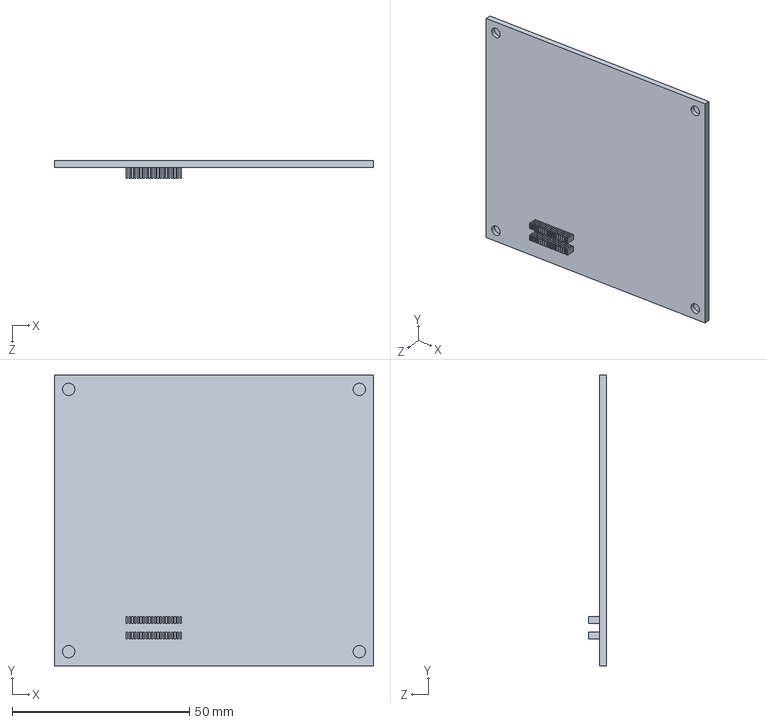
[picture p71: CAD file, 2020-03-31]
3D CAD Models/carte clairitec.SLDPRT
90.0 x 82.0 x 5.00 mm
