ac-ctrl/Medtronic-PB560-Ventilator-System/3D CAD Models/MODULE PRISE 230+INTER.SLDPRT

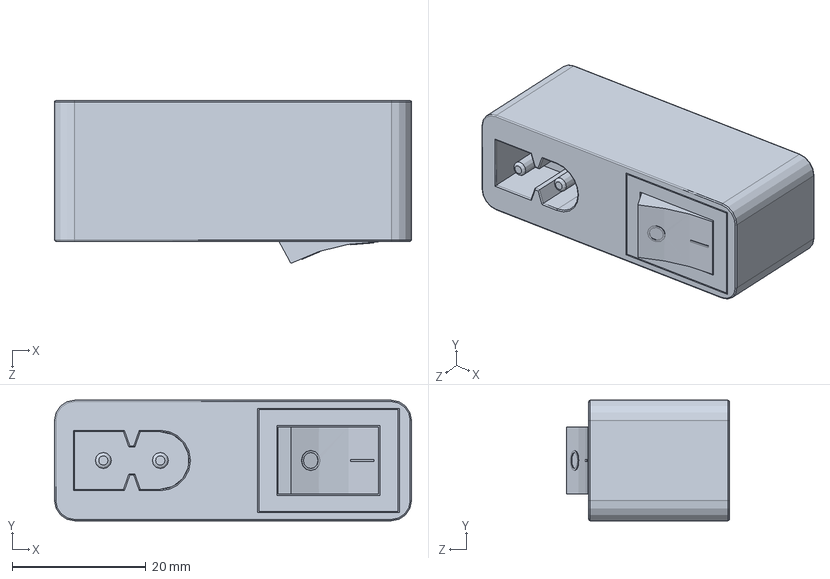
[picture p72: CAD file, 2020-03-31]
3D CAD Models/MODULE PRISE 230+INTER.SLDPRT
53.3 x 18.0 x 24.3 mm
