ac-ctrl/Medtronic-PB560-Ventilator-System/3D CAD Models/Coude banjo M5-tuyau 6.SLDPRT

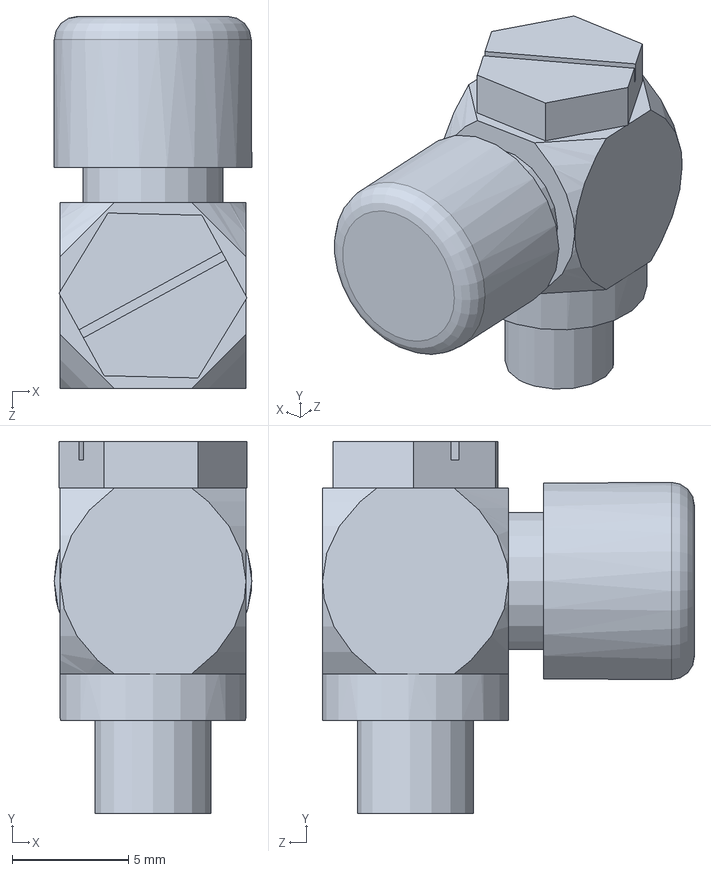
[picture p73: CAD file, 2020-03-31]
3D CAD Models/Coude banjo M5-tuyau 6.SLDPRT
8.50 x 16.0 x 16.0 mm
