ac-ctrl/Medtronic-PB560-Ventilator-System/3D CAD Models/thermistances CTN.SLDPRT

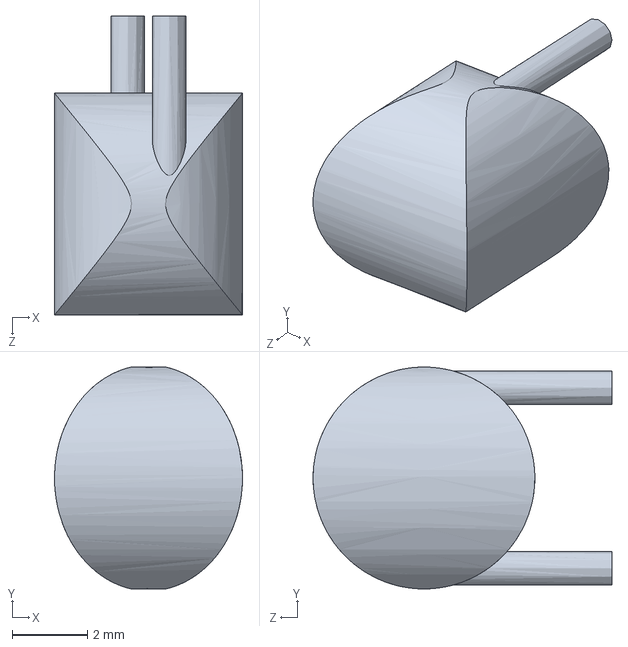
[picture p74: CAD file, 2020-03-31]
3D CAD Models/thermistances CTN.SLDPRT
5.00 x 5.90 x 7.95 mm
