ac-ctrl/Medtronic-PB560-Ventilator-System/3D CAD Models/22-27-2021.SLDPRT

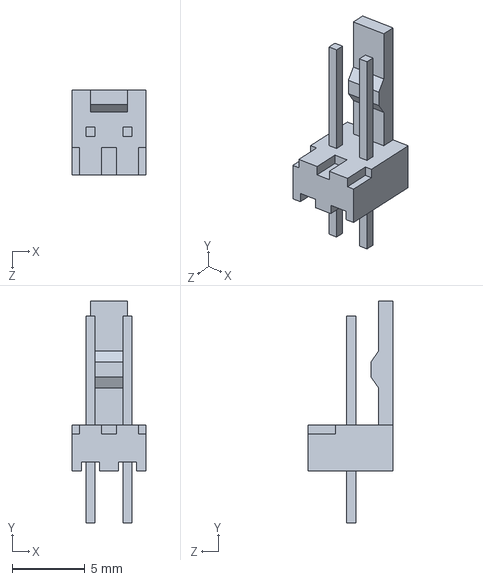
[picture p75: CAD file, 2020-03-31]
3D CAD Models/22-27-2021.SLDPRT
5.08 x 15.2 x 5.84 mm
