ac-ctrl/Medtronic-PB560-Ventilator-System/3D CAD Models/entretoise hexa  m3x12.SLDPRT

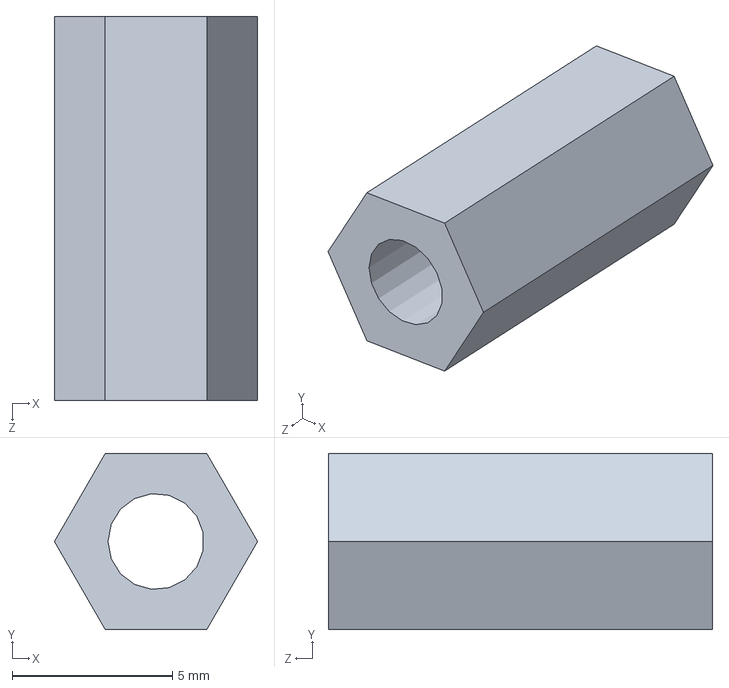
[picture p76: CAD file, 2020-03-31]
3D CAD Models/entretoise hexa m3x12.SLDPRT
6.35 x 5.50 x 12.0 mm
