ac-ctrl/Medtronic-PB560-Ventilator-System/3D CAD Models/capot 3 capteurs P phase 2.SLDPRT

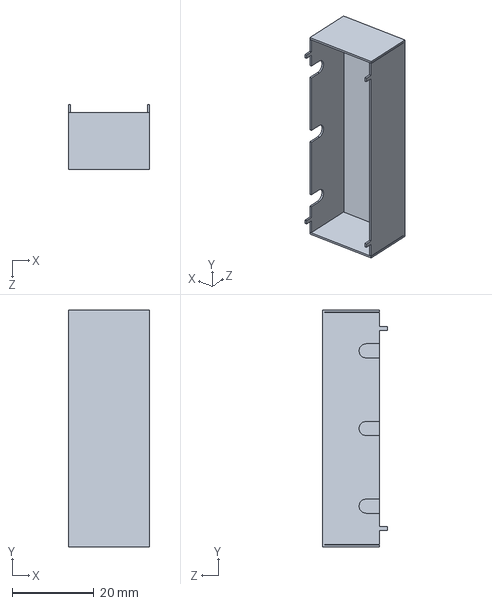
[picture p77: CAD file, 2020-03-31]
3D CAD Models/capot 3 capteurs P phase 2.SLDPRT
19.9 x 58.0 x 16.0 mm
