ac-ctrl/Medtronic-PB560-Ventilator-System/3D CAD Models/capteur pression absolue.SLDPRT

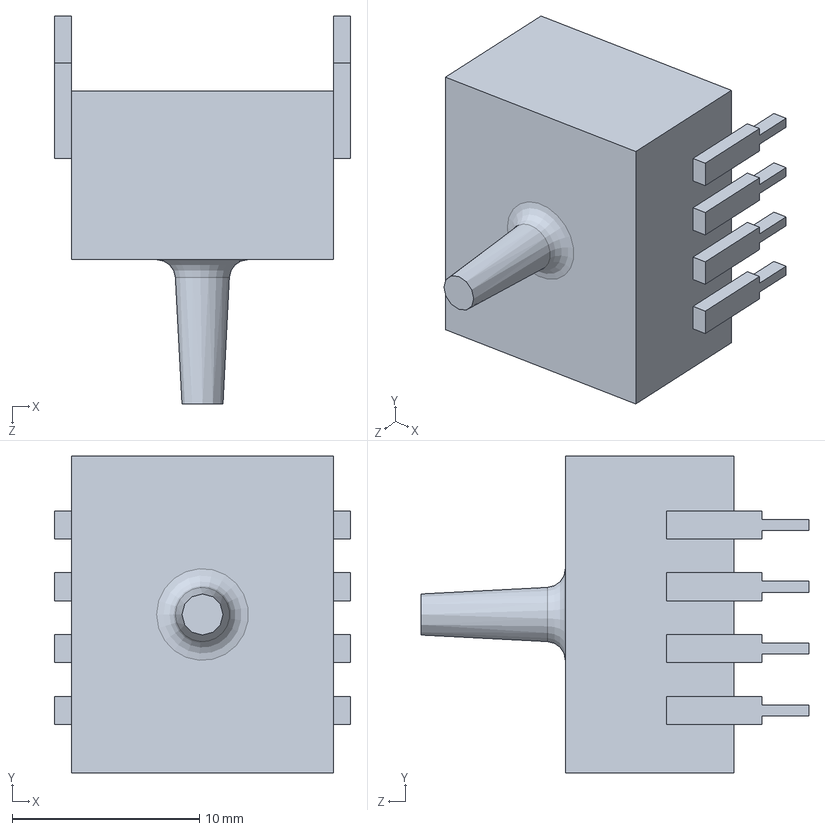
[picture p78: CAD file, 2020-03-31]
3D CAD Models/capteur pression absolue.SLDPRT
15.8 x 16.9 x 20.7 mm
