ac-ctrl/Medtronic-PB560-Ventilator-System/3D CAD Models/09-48-4038.SLDPRT

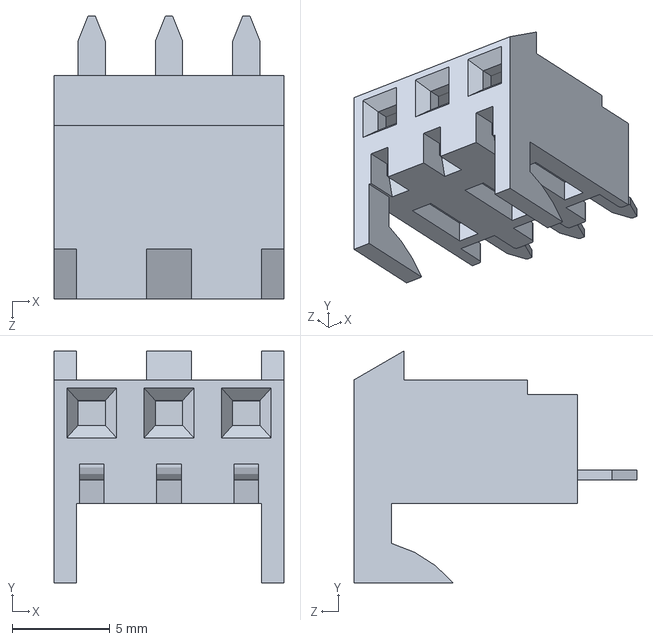
[picture p79: CAD file, 2020-03-31]
3D CAD Models/09-48-4038.SLDPRT
11.8 x 11.9 x 14.5 mm
