ac-ctrl/Medtronic-PB560-Ventilator-System/3D CAD Models/tuyau pression prox1.6x4.8.SLDPRT

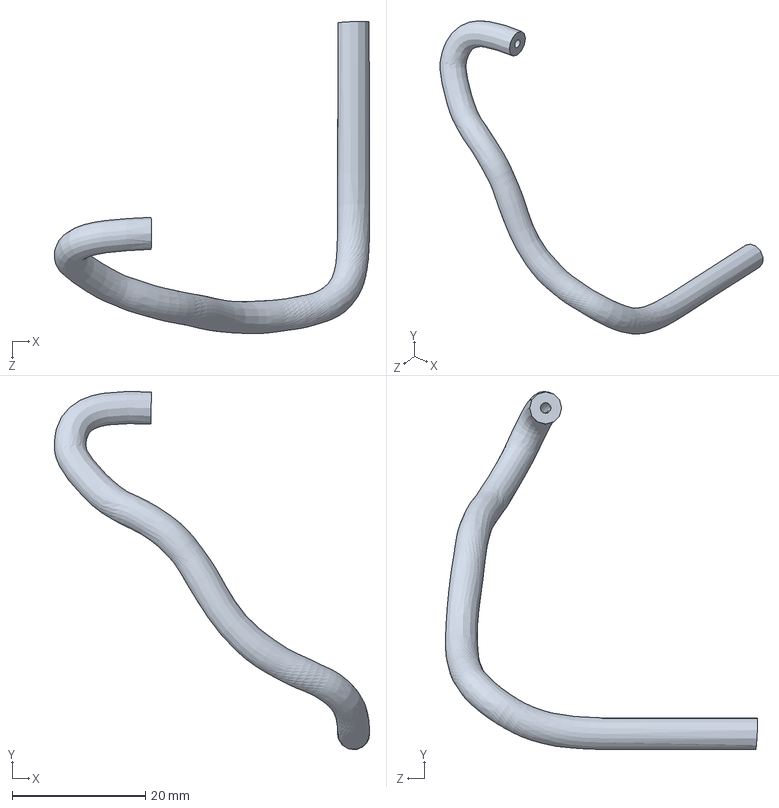
[picture p80: CAD file, 2020-03-31]
3D CAD Models/tuyau pression prox1.6x4.8.SLDPRT
47.2 x 53.6 x 46.8 mm
