ac-ctrl/Medtronic-PB560-Ventilator-System/3D CAD Models/tuyau alim ballonnet1.6x4.8.SLDPRT

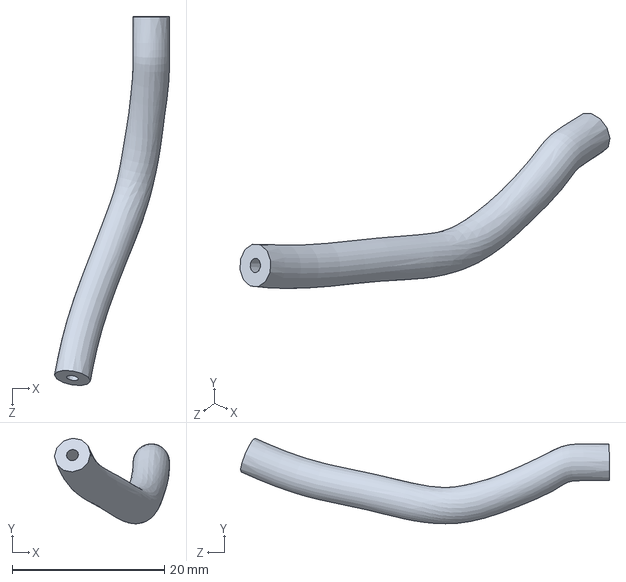
[picture p81: CAD file, 2020-03-31]
3D CAD Models/tuyau alim ballonnet1.6x4.8.SLDPRT
15.1 x 11.2 x 48.5 mm
