ac-ctrl/Medtronic-PB560-Ventilator-System/3D CAD Models/isolant adhésif ens afficheur.SLDPRT

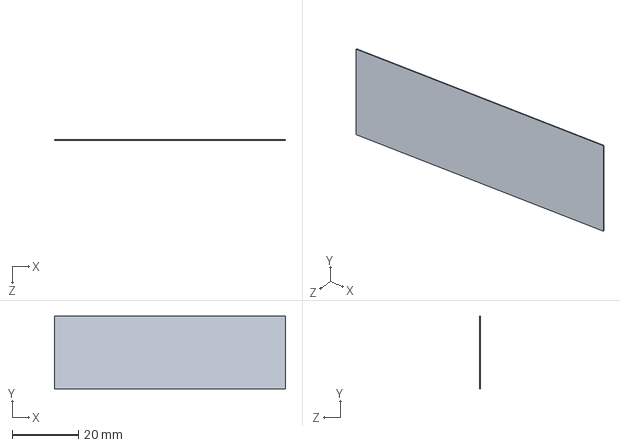
[picture p82: CAD file, 2020-03-31]
3D CAD Models/isolant adhésif ens afficheur.SLDPRT
70.0 x 22.0 x 0.2 mm
