ac-ctrl/Medtronic-PB560-Ventilator-System/3D CAD Models/capteurpressionASDX100D44R.SLDPRT

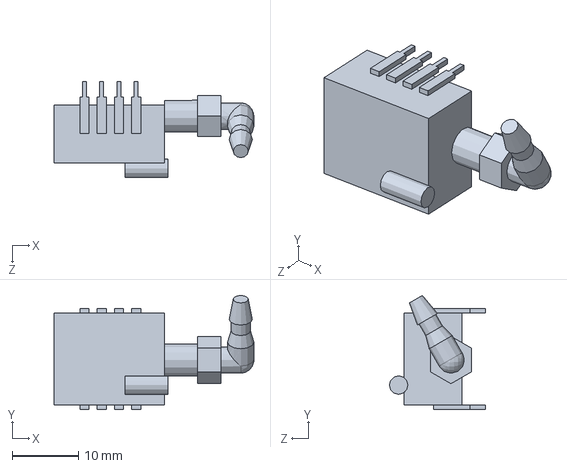
[picture p83: CAD file, 2020-03-31]
3D CAD Models/capteurpressionASDX100D44R.SLDPRT
30.2 x 17.2 x 14.5 mm
