ac-ctrl/Medtronic-PB560-Ventilator-System/3D CAD Models/Insp Mod Connector.SLDPRT

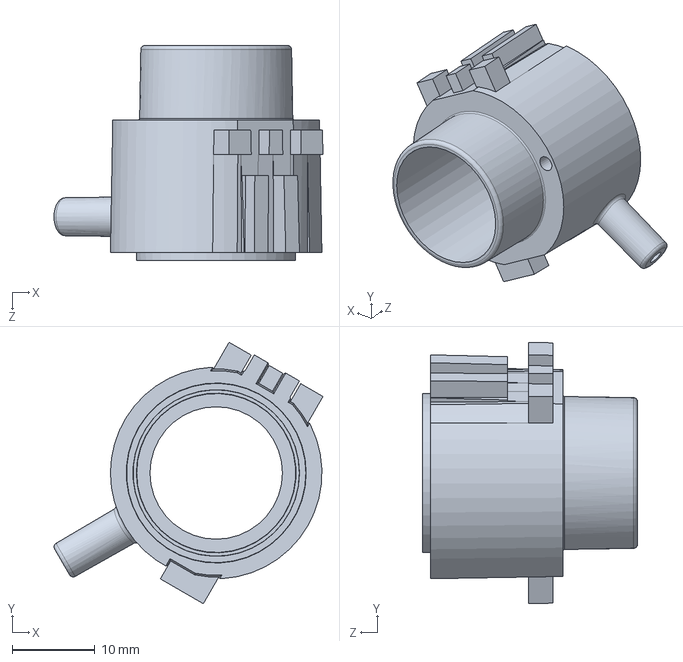
[picture p84: CAD file, 2020-03-31]
3D CAD Models/Insp Mod Connector.SLDPRT
32.5 x 31.6 x 26.0 mm
