ac-ctrl/Medtronic-PB560-Ventilator-System/3D CAD Models/condensateur C88.SLDPRT

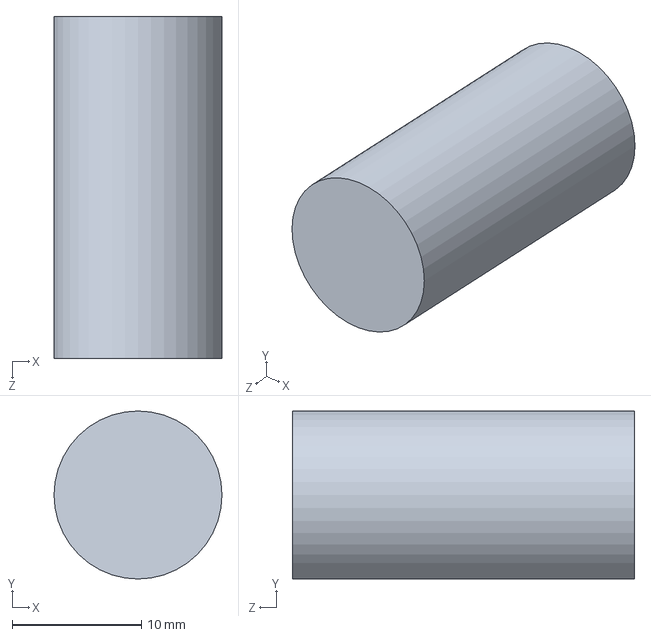
[picture p85: CAD file, 2020-03-31]
3D CAD Models/condensateur C88.SLDPRT
13.0 x 13.0 x 26.5 mm
