ac-ctrl/Medtronic-PB560-Ventilator-System/3D CAD Models/3M 4032 x30mm.SLDPRT

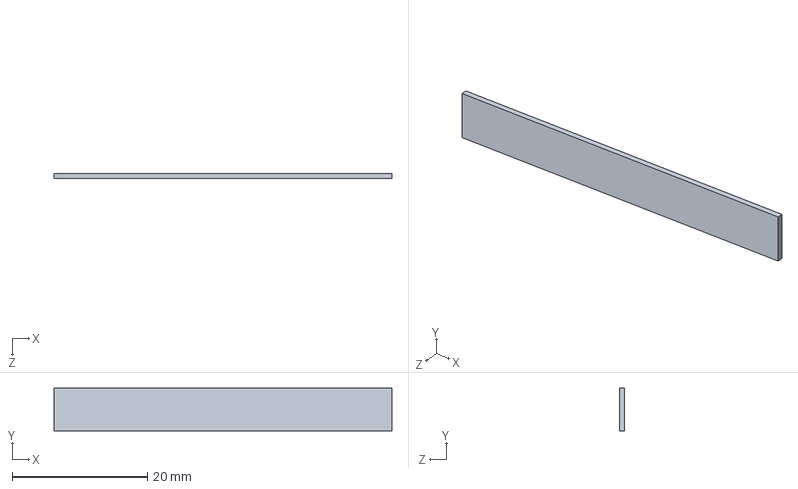
[picture p86: CAD file, 2020-03-31]
3D CAD Models/3M 4032 x30mm.SLDPRT
50.0 x 6.35 x 0.8 mm
