ac-ctrl/Medtronic-PB560-Ventilator-System/3D CAD Models/cache transfo.SLDPRT

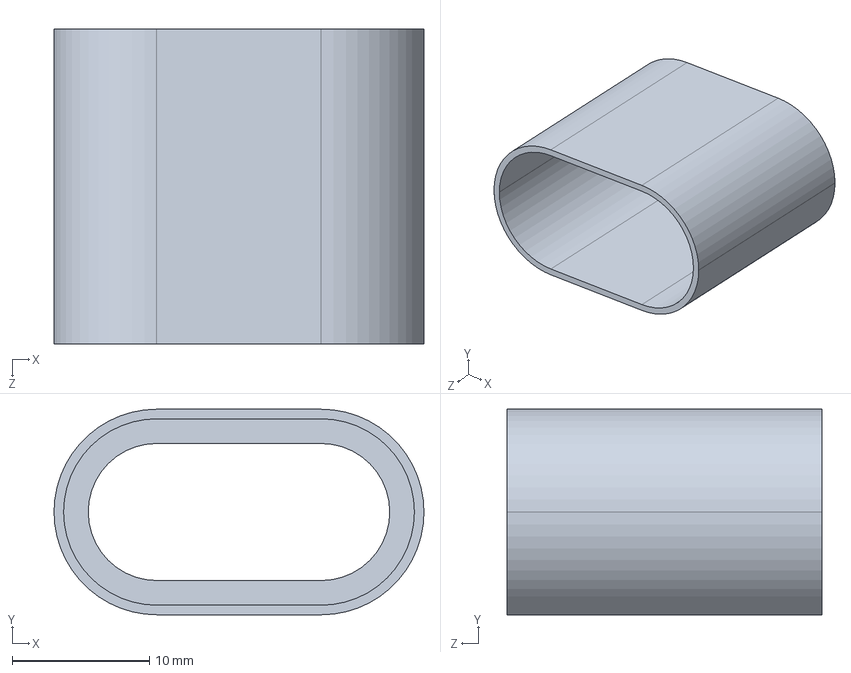
[picture p87: CAD file, 2020-03-31]
3D CAD Models/cache transfo.SLDPRT
27.0 x 15.0 x 23.0 mm
