ac-ctrl/Medtronic-PB560-Ventilator-System/3D CAD Models/alimentation phase 2.SLDPRT

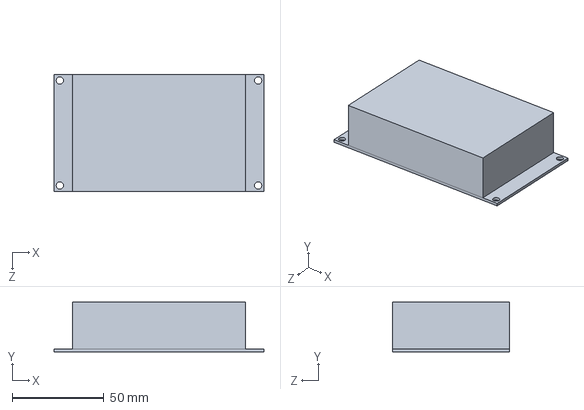
[picture p88: CAD file, 2020-03-31]
3D CAD Models/alimentation phase 2.SLDPRT
114.3 x 27.0 x 63.5 mm
