ac-ctrl/Medtronic-PB560-Ventilator-System/3D CAD Models/AFFICHEUR TWIN.SLDPRT

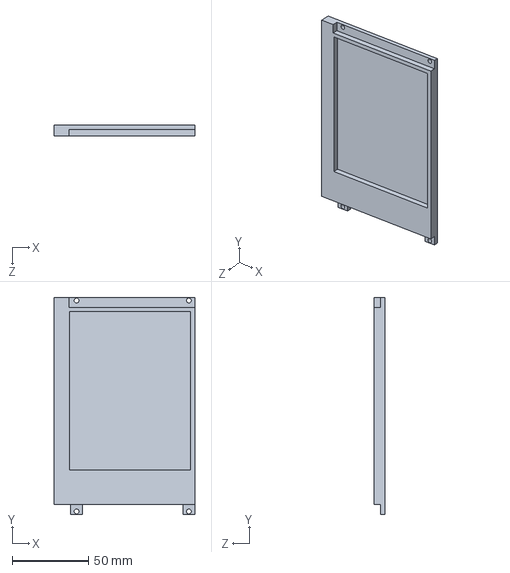
[picture p89: CAD file, 2020-03-31]
3D CAD Models/AFFICHEUR TWIN.SLDPRT
92.6 x 142.6 x 7.00 mm
