ac-ctrl/Medtronic-PB560-Ventilator-System/3D CAD Models/connect molex 22-01-2025.SLDPRT

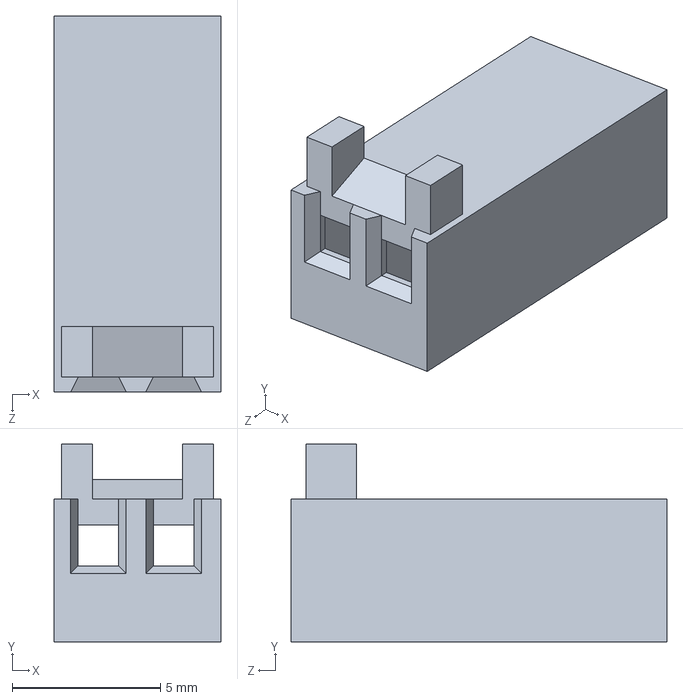
[picture p90: CAD file, 2020-03-31]
3D CAD Models/connect molex 22-01-2025.SLDPRT
5.64 x 6.68 x 12.7 mm
