ac-ctrl/Medtronic-PB560-Ventilator-System/3D CAD Models/switch.SLDPRT

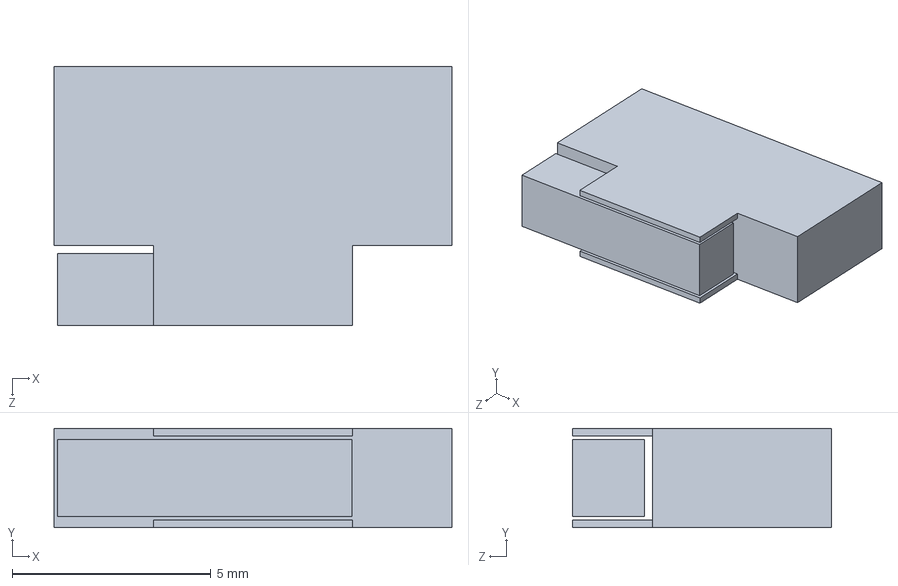
[picture p92: CAD file, 2020-03-31]
3D CAD Models/switch.SLDPRT
10.0 x 2.50 x 6.50 mm
