ac-ctrl/Medtronic-PB560-Ventilator-System/3D CAD Models/tuyau alim vanne 1.6x4.8.SLDPRT

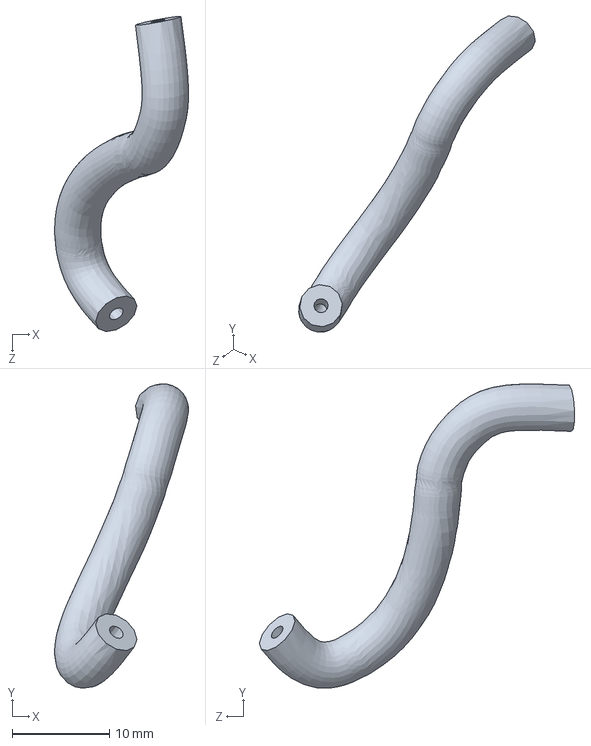
[picture p93: CAD file, 2020-03-31]
3D CAD Models/tuyau alim vanne 1.6x4.8.SLDPRT
13.8 x 31.3 x 32.5 mm
