ac-ctrl/Medtronic-PB560-Ventilator-System/3D CAD Models/entretoise richco lg16.SLDPRT

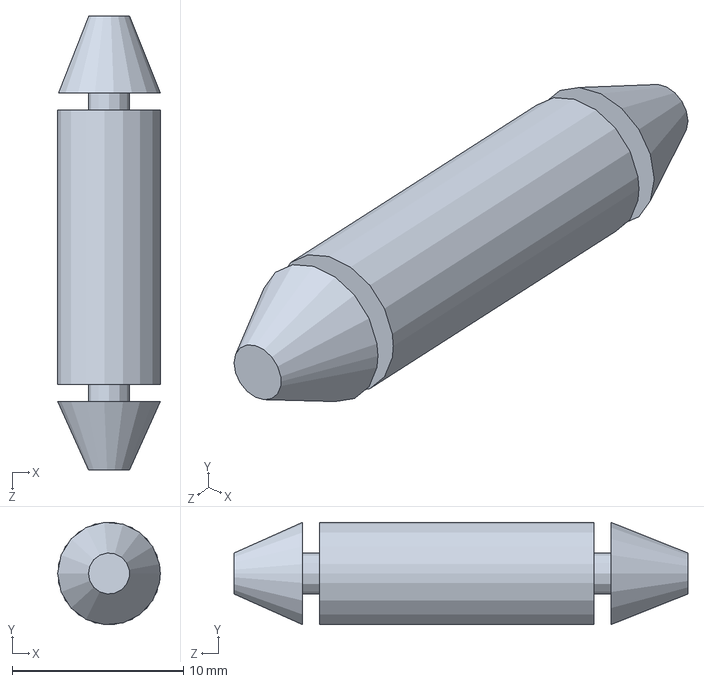
[picture p94: CAD file, 2020-03-31]
3D CAD Models/entretoise richco lg16.SLDPRT
6.00 x 5.97 x 26.5 mm
