ac-ctrl/Medtronic-PB560-Ventilator-System/3D CAD Models/26-48-1035.SLDPRT

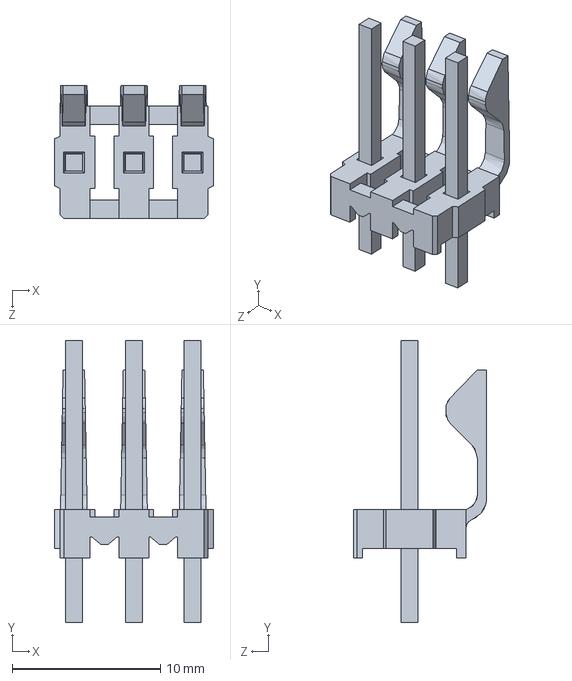
[picture p95: CAD file, 2020-03-31]
3D CAD Models/26-48-1035.SLDPRT
10.7 x 19.1 x 9.02 mm
