ac-ctrl/Medtronic-PB560-Ventilator-System/3D CAD Models/09-48-4128.SLDPRT

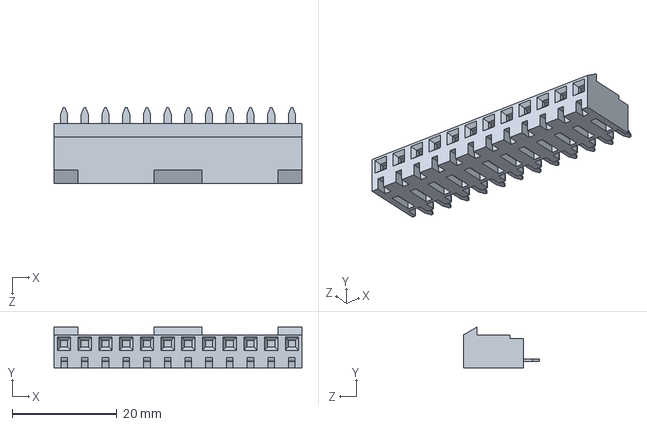
[picture p96: CAD file, 2020-03-31]
3D CAD Models/09-48-4128.SLDPRT
47.4 x 7.82 x 14.5 mm
