ac-ctrl/Medtronic-PB560-Ventilator-System/3D CAD Models/tuyau sortie vanne pilot1.6x4.8.SLDPRT

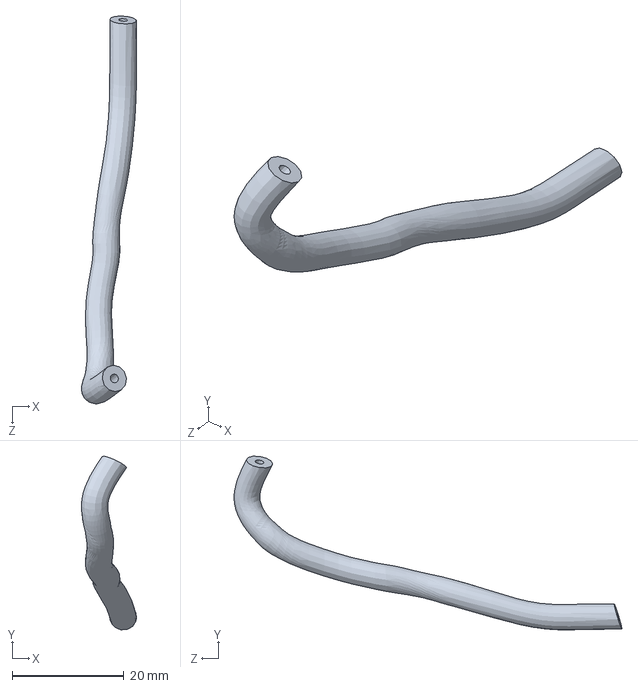
[picture p97: CAD file, 2020-03-31]
3D CAD Models/tuyau sortie vanne pilot1.6x4.8.SLDPRT
9.88 x 31.1 x 69.5 mm
