ac-ctrl/Medtronic-PB560-Ventilator-System/3D CAD Models/connecteur 12-30V.SLDPRT

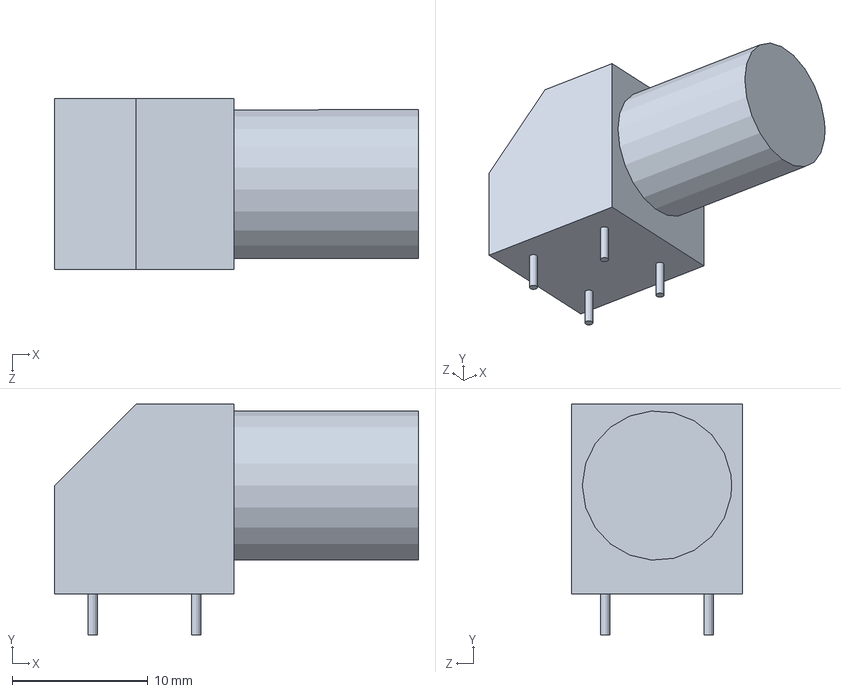
[picture p98: CAD file, 2020-03-31]
3D CAD Models/connecteur 12-30V.SLDPRT
26.8 x 17.0 x 12.6 mm
