ac-ctrl/Medtronic-PB560-Ventilator-System/3D CAD Models/MOLEX 43645 0200.SLDPRT

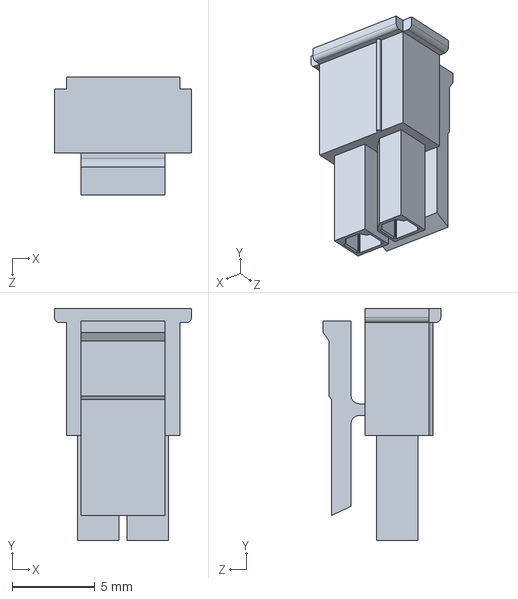
[picture p99: CAD file, 2020-03-31]
3D CAD Models/MOLEX 43645 0200.SLDPRT
8.28 x 14.0 x 7.10 mm
