ac-ctrl/Medtronic-PB560-Ventilator-System/3D CAD Models/tuyau O2 entrée vanne.SLDPRT

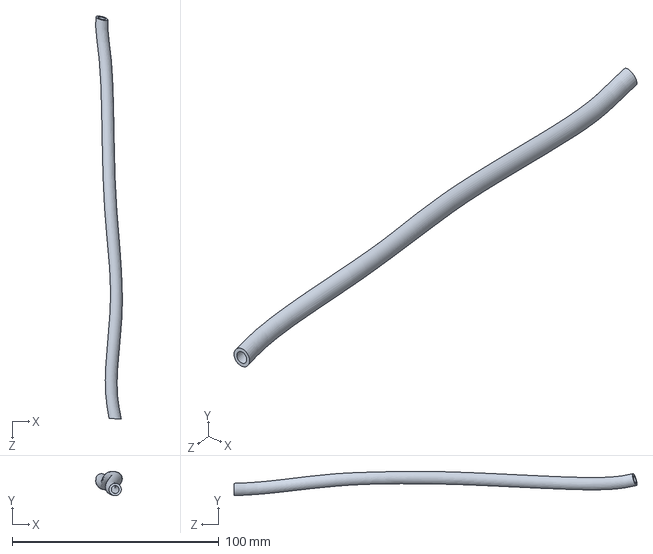
[picture p100: CAD file, 2020-03-31]
3D CAD Models/tuyau O2 entrée vanne.SLDPRT
12.9 x 11.8 x 195.1 mm
