ac-ctrl/Medtronic-PB560-Ventilator-System/3D CAD Models/I0 179 Entretoise Mediane Legendair.SLDPRT

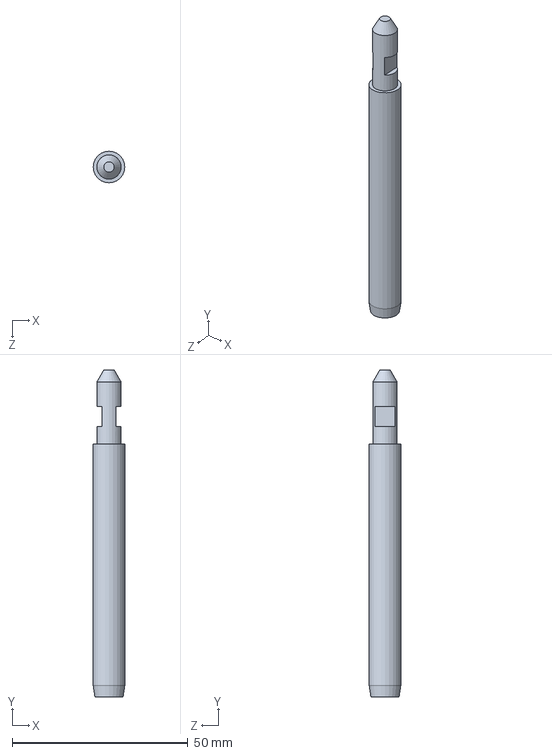
[picture p101: CAD file, 2020-03-31]
3D CAD Models/I0 179 Entretoise Mediane Legendair.SLDPRT
9.00 x 93.0 x 9.00 mm
