ac-ctrl/Medtronic-PB560-Ventilator-System/3D CAD Models/26-48-1125.SLDPRT

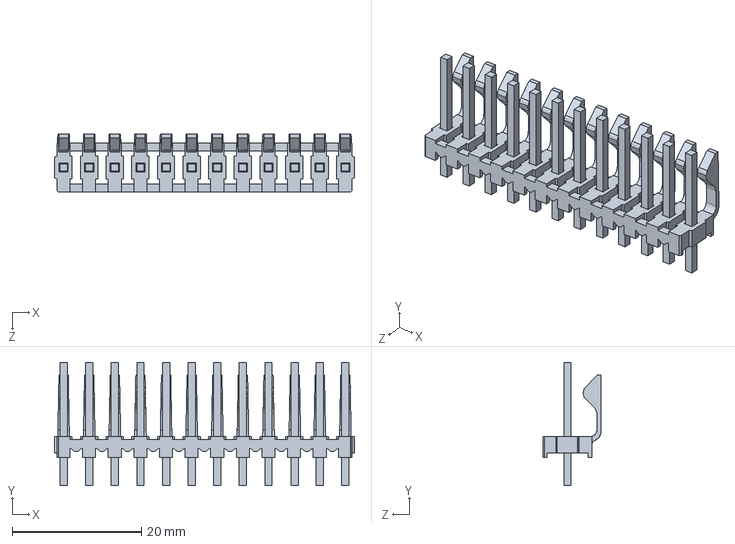
[picture p102: CAD file, 2020-03-31]
3D CAD Models/26-48-1125.SLDPRT
46.4 x 19.1 x 9.02 mm
