ac-ctrl/Medtronic-PB560-Ventilator-System/3D CAD Models/INGUN GKS 913 305 230 A 15 02 S.SLDPRT

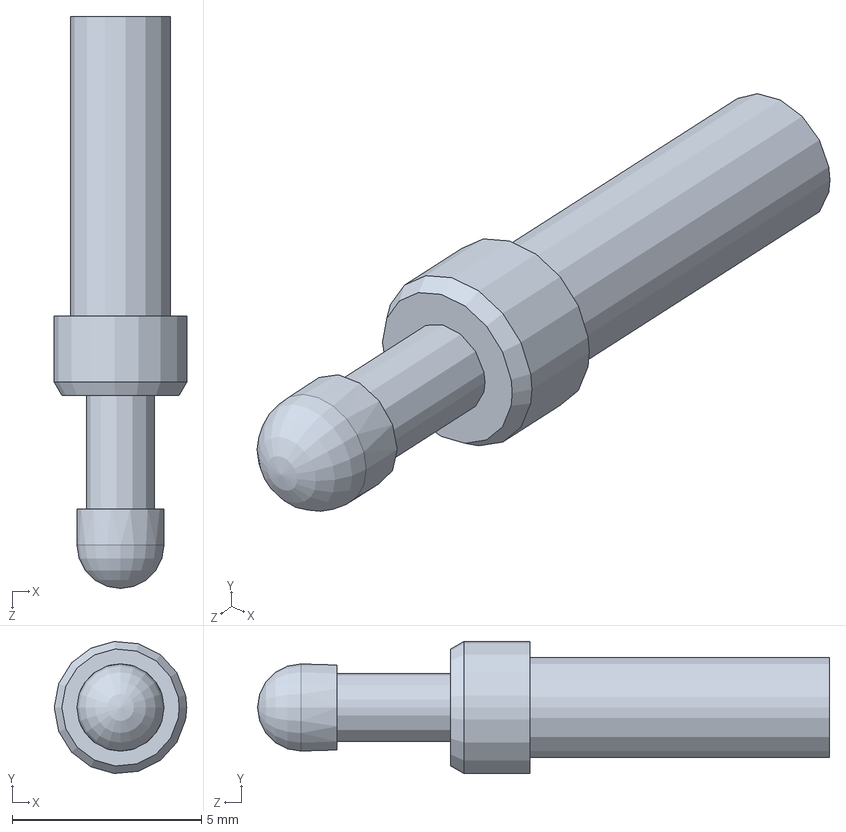
[picture p103: CAD file, 2020-03-31]
3D CAD Models/INGUN GKS 913 305 230 A 15 02 S.SLDPRT
3.50 x 3.49 x 15.1 mm
