ac-ctrl/Medtronic-PB560-Ventilator-System/3D CAD Models/embase cpu.SLDPRT

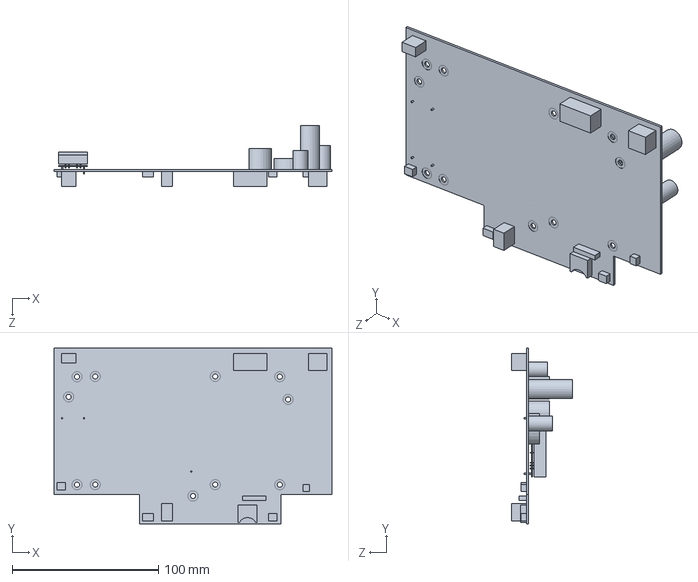
[picture p104: CAD file, 2020-03-31]
3D CAD Models/embase cpu.SLDPRT
190.0 x 120.0 x 41.5 mm
