ac-ctrl/Medtronic-PB560-Ventilator-System/3D CAD Models/Cable tie (ref AML).SLDPRT

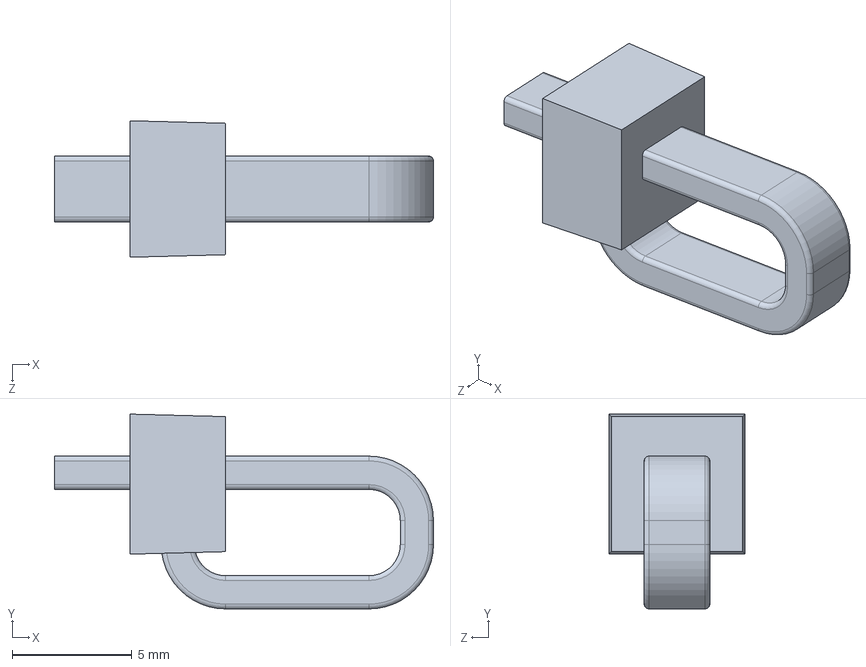
[picture p105: CAD file, 2020-03-31]
3D CAD Models/Cable tie (ref AML).SLDPRT
15.9 x 8.15 x 5.71 mm
