ac-ctrl/Medtronic-PB560-Ventilator-System/3D CAD Models/tuyau débit expi P1.SLDPRT

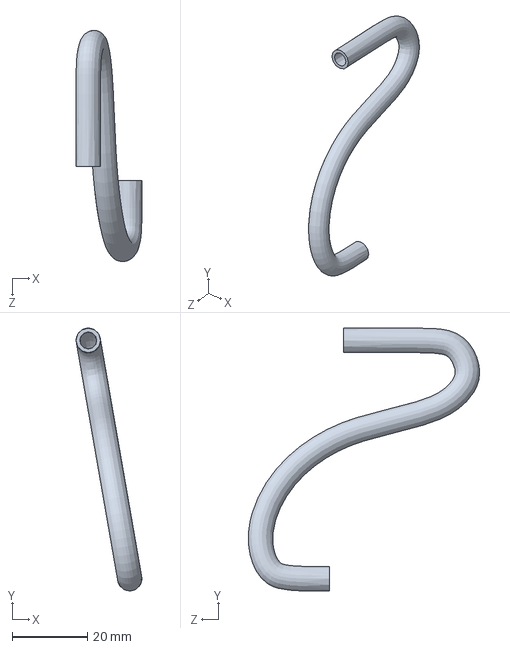
[picture p106: CAD file, 2020-03-31]
3D CAD Models/tuyau débit expi P1.SLDPRT
17.5 x 69.7 x 61.3 mm
