ac-ctrl/Medtronic-PB560-Ventilator-System/3D CAD Models/etiq reperage vanne O2.SLDPRT

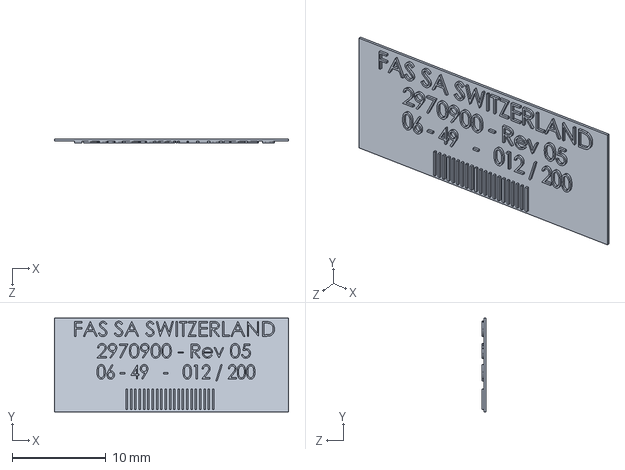
[picture p107: CAD file, 2020-03-31]
3D CAD Models/etiq reperage vanne O2.SLDPRT
25.0 x 10.0 x 0.4 mm
