ac-ctrl/Medtronic-PB560-Ventilator-System/3D CAD Models/embase cpu légendair phase 2 ind 01.SLDPRT

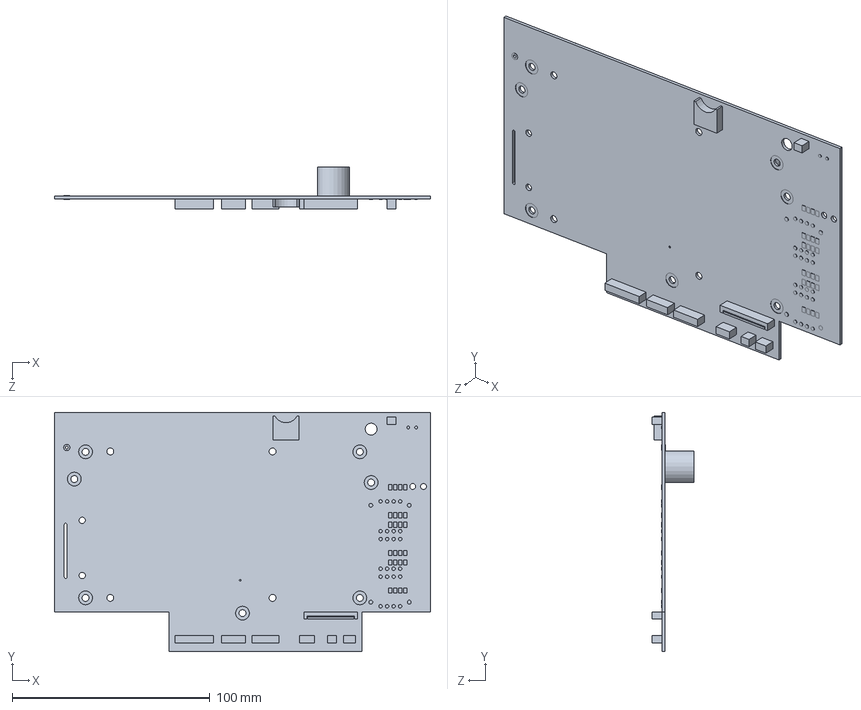
[picture p108: CAD file, 2020-03-31]
3D CAD Models/embase cpu légendair phase 2 ind 01.SLDPRT
190.0 x 121.0 x 21.0 mm
