ac-ctrl/Medtronic-PB560-Ventilator-System/3D CAD Models/Batt Contacts tab.SLDPRT

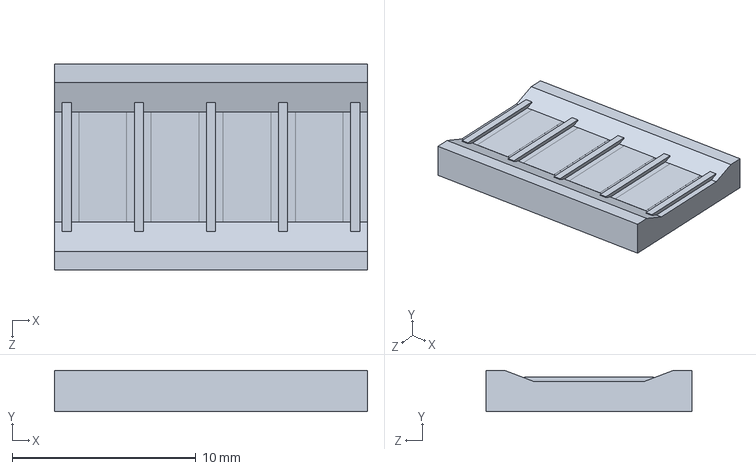
[picture p109: CAD file, 2020-03-31]
3D CAD Models/Batt Contacts tab.SLDPRT
17.0 x 2.25 x 11.2 mm
