ac-ctrl/Medtronic-PB560-Ventilator-System/3D CAD Models/MOLEX 22-05-7098.SLDPRT

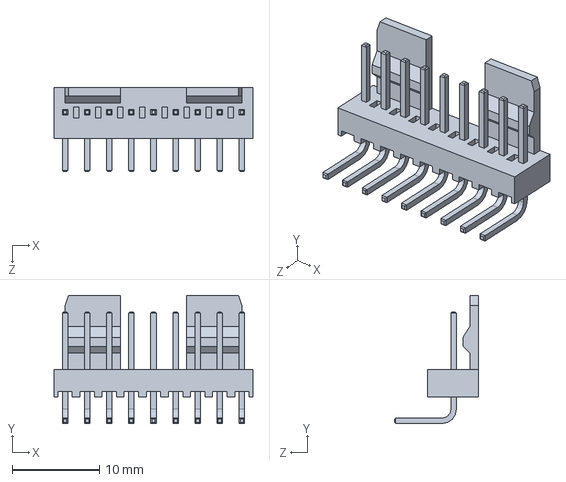
[picture p110: CAD file, 2020-03-31]
3D CAD Models/MOLEX 22-05-7098.SLDPRT
22.9 x 14.7 x 9.65 mm
