ac-ctrl/Medtronic-PB560-Ventilator-System/3D CAD Models/self debout.SLDPRT

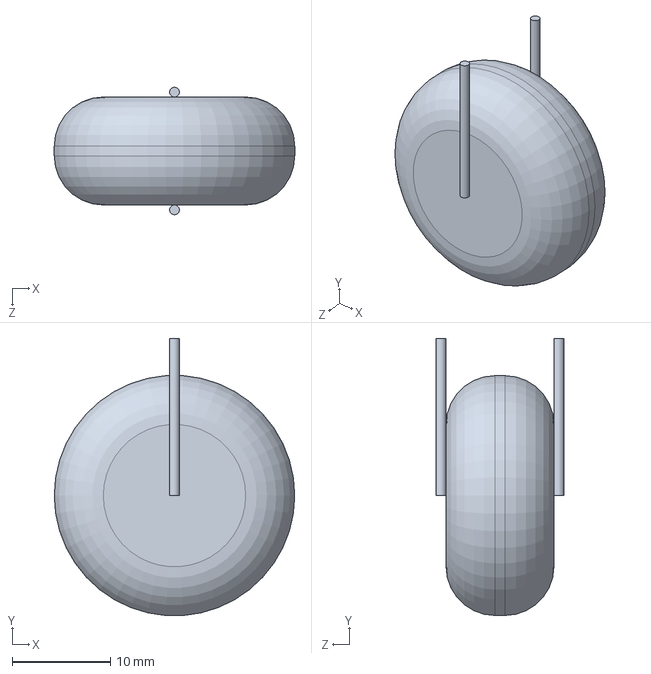
[picture p111: CAD file, 2020-03-31]
3D CAD Models/self debout.SLDPRT
24.5 x 28.2 x 13.0 mm
