ac-ctrl/Medtronic-PB560-Ventilator-System/3D CAD Models/Exh Valve connector.SLDPRT

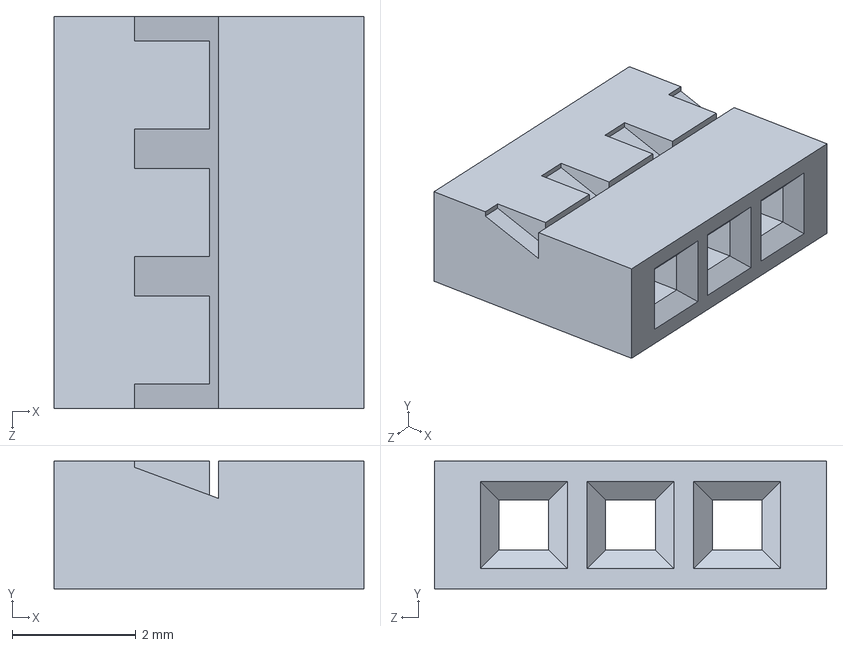
[picture p112: CAD file, 2020-03-31]
3D CAD Models/Exh Valve connector.SLDPRT
5.00 x 2.06 x 6.33 mm
