ac-ctrl/Medtronic-PB560-Ventilator-System/3D CAD Models/capteurpressionASDX001D44R.SLDPRT

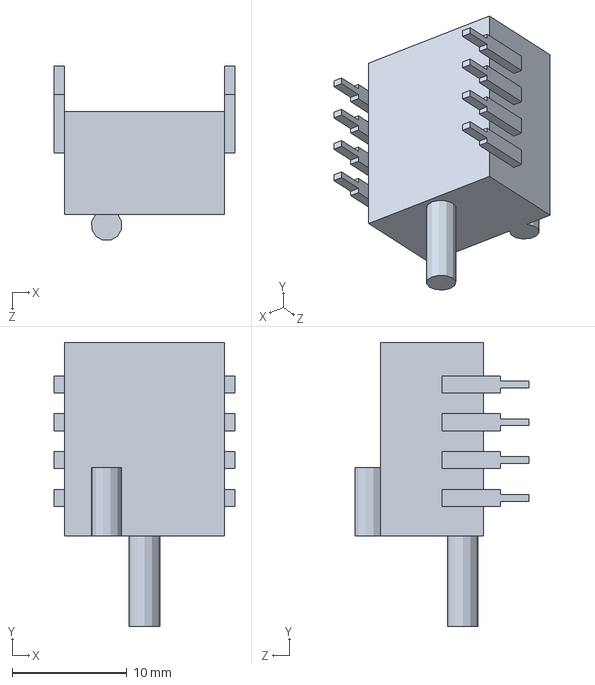
[picture p113: CAD file, 2020-03-31]
3D CAD Models/capteurpressionASDX001D44R.SLDPRT
15.8 x 24.8 x 15.2 mm
