ac-ctrl/Medtronic-PB560-Ventilator-System/3D CAD Models/condensateur dia 10.SLDPRT

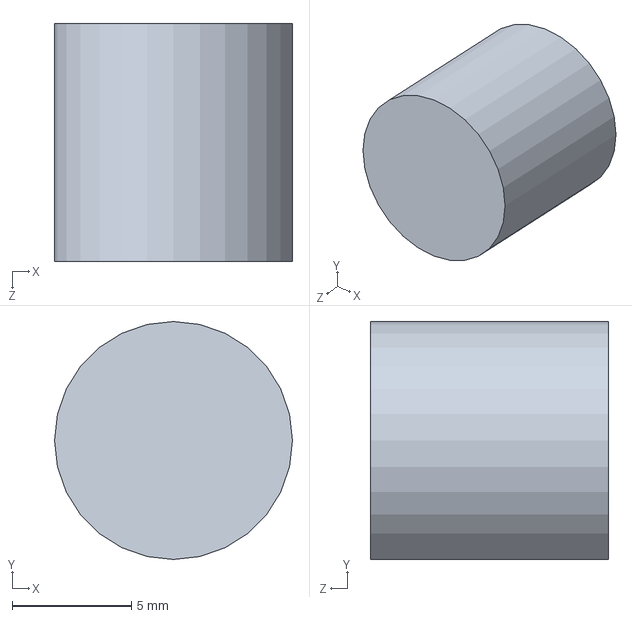
[picture p114: CAD file, 2020-03-31]
3D CAD Models/condensateur dia 10.SLDPRT
10.0 x 10.0 x 10.0 mm
