ac-ctrl/Medtronic-PB560-Ventilator-System/3D CAD Models/Rondelle plate - ZU  3 x 6 EP 0.8.sldprt

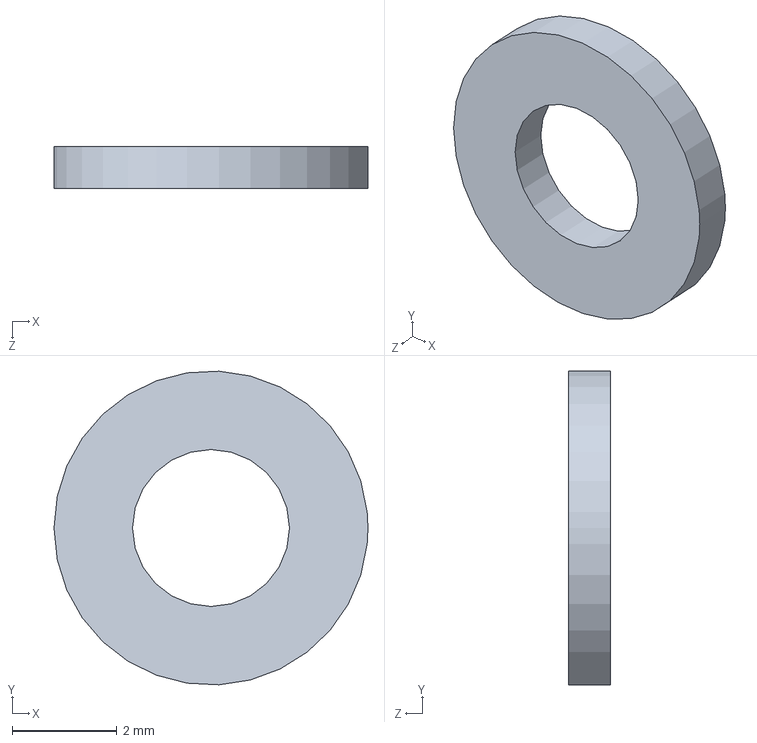
[picture p115: CAD file, 2020-03-31]
3D CAD Models/Rondelle plate - ZU 3 x 6 EP 0.8.sldprt
6.00 x 5.99 x 0.8 mm
