ac-ctrl/Medtronic-PB560-Ventilator-System/3D CAD Models/39-28-5104.SLDPRT

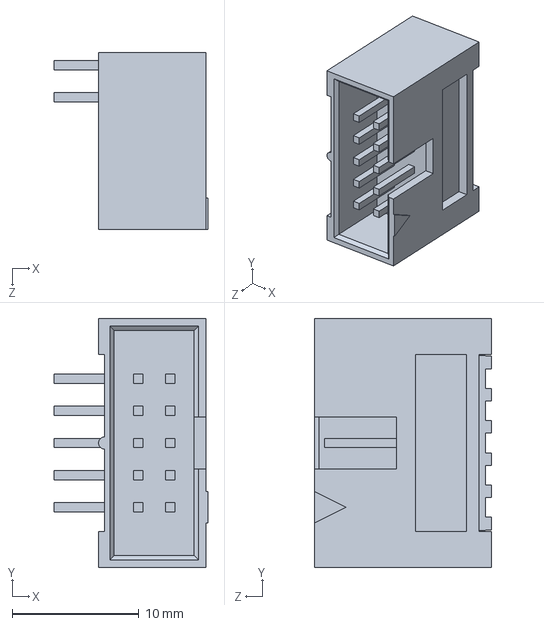
[picture p116: CAD file, 2020-03-31]
3D CAD Models/39-28-5104.SLDPRT
12.1 x 19.7 x 14.0 mm
