ac-ctrl/Medtronic-PB560-Ventilator-System/3D CAD Models/Back End Cap.SLDPRT

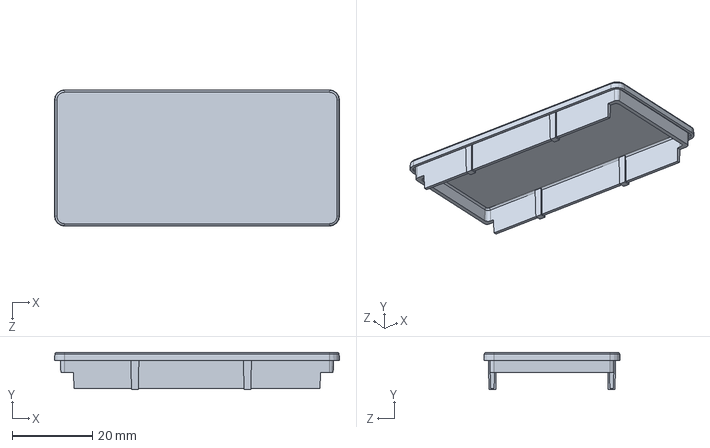
[picture p117: CAD file, 2020-03-31]
3D CAD Models/Back End Cap.SLDPRT
70.9 x 9.30 x 33.9 mm
