ac-ctrl/Medtronic-PB560-Ventilator-System/3D CAD Models/39-26-7265.SLDPRT

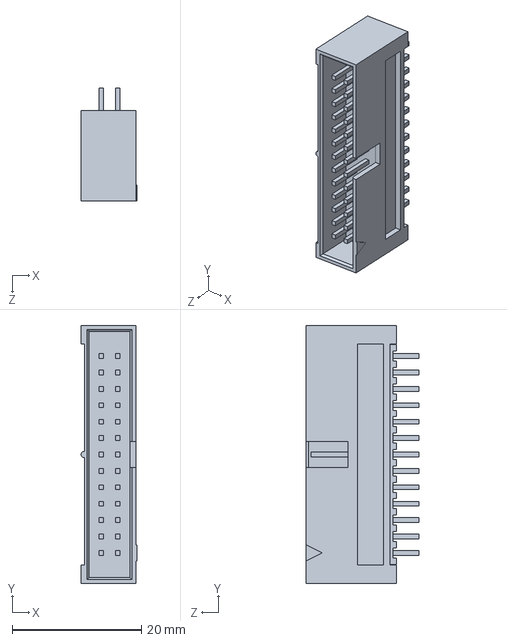
[picture p118: CAD file, 2020-03-31]
3D CAD Models/39-26-7265.SLDPRT
8.65 x 40.0 x 17.5 mm
