ac-ctrl/Medtronic-PB560-Ventilator-System/3D CAD Models/tuyau alim vanne 4x6.SLDPRT

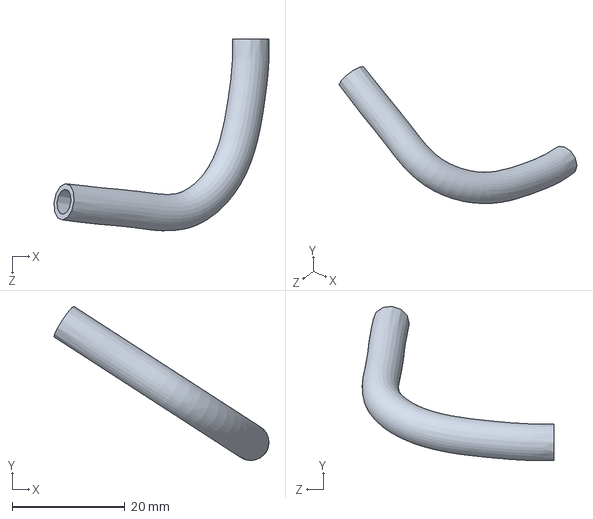
[picture p119: CAD file, 2020-03-31]
3D CAD Models/tuyau alim vanne 4x6.SLDPRT
38.2 x 27.4 x 34.1 mm
