ac-ctrl/Medtronic-PB560-Ventilator-System/3D CAD Models/tuyau débit expi P2.SLDPRT

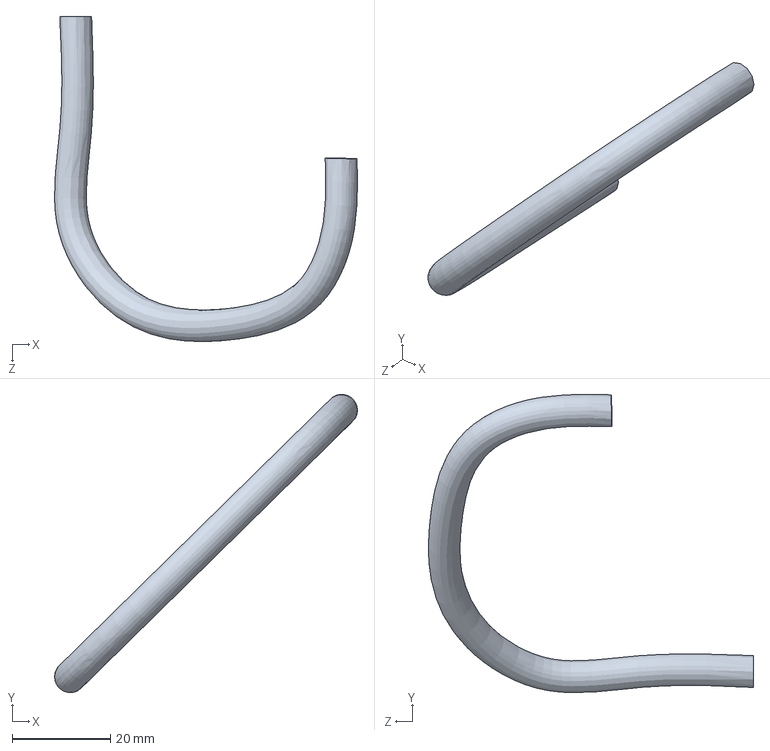
[picture p120: CAD file, 2020-03-31]
3D CAD Models/tuyau débit expi P2.SLDPRT
61.8 x 60.8 x 66.3 mm
