ac-ctrl/Medtronic-PB560-Ventilator-System/3D CAD Models/Vis TCB M3-12 hexalobes acier zingué.sldprt

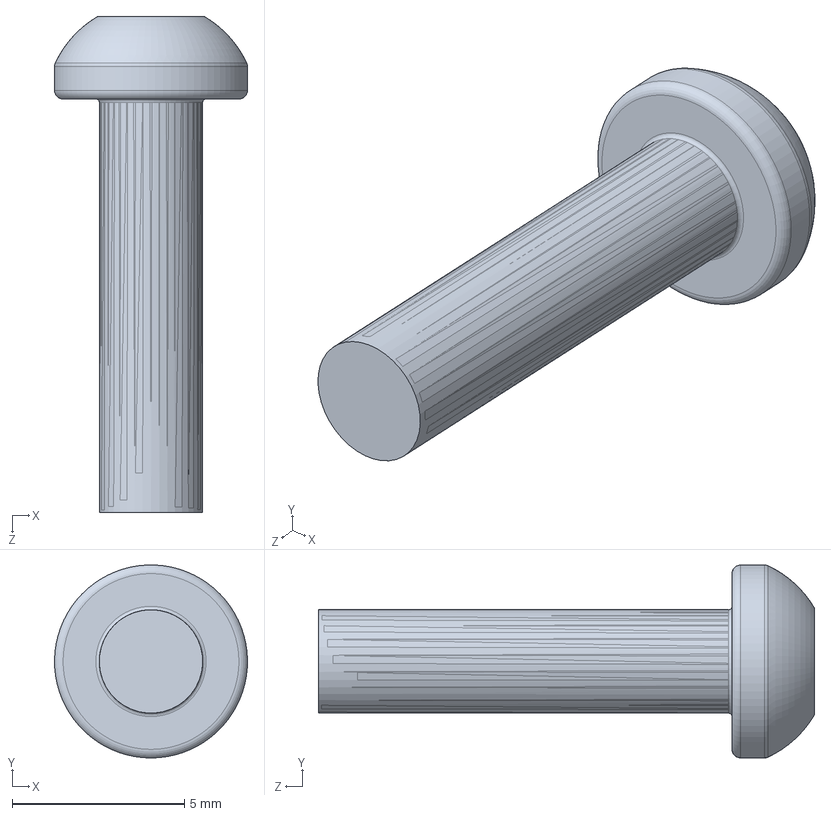
[picture p121: CAD file, 2020-03-31]
3D CAD Models/Vis TCB M3-12 hexalobes acier zingué.sldprt
5.60 x 5.60 x 14.4 mm
