ac-ctrl/Medtronic-PB560-Ventilator-System/3D CAD Models/connect molex 22-01-2087.SLDPRT

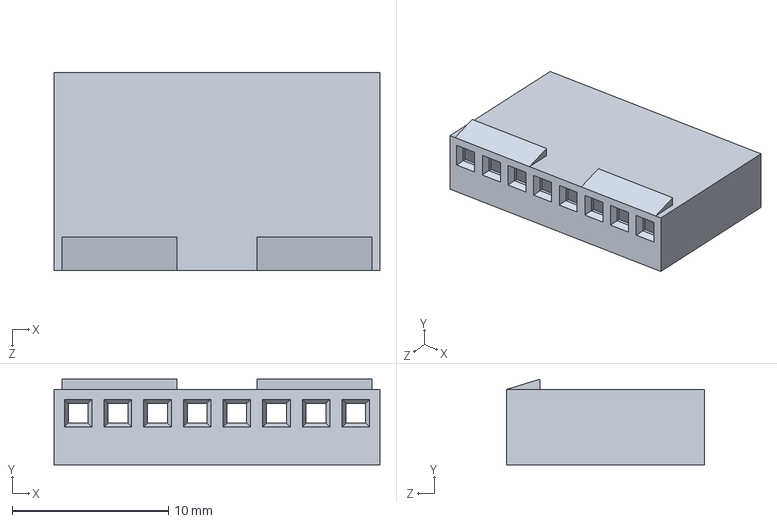
[picture p122: CAD file, 2020-03-31]
3D CAD Models/connect molex 22-01-2087.SLDPRT
20.9 x 5.49 x 12.7 mm
