ac-ctrl/Medtronic-PB560-Ventilator-System/(list of files, cad)

Other CAD files:
BOM Drawings/PB560 PowerPack/10109801A00/Switchcraft L712AS.sldasm
3D CAD Models/PMCD1204.sldasm
3D CAD Models/_PMC_LATCH_4.sldprt
3D CAD Models/double face.SLDPRT
3D CAD Models/filtre murata.SLDPRT
3D CAD Models/_100901_6.sldprt
3D CAD Models/_PMCD1204_BODY_2.sldprt
3D CAD Models/_100800_8.sldprt
3D CAD Models/HARTING 09185107323.SLDPRT
3D CAD Models/039281023.SLDPRT
3D CAD Models/10049560_Fan Assy (ref ASM).SLDASM
3D CAD Models/10049560_Routed wires (asm ref Part).SLDPRT
3D CAD Models/10049560_ventil SUNON 40x40x20.SLDPRT
3D CAD Models/10079556.SLDASM
3D CAD Models/10079556_Support.SLDPRT
3D CAD Models/10093284.SLDPRT
3D CAD Models/10096315.SLDASM
3D CAD Models/10096505_Board (ref ECAD).SLDPRT
3D CAD Models/10096509.SLDASM
3D CAD Models/10096510.sldasm
3D CAD Models/10096510_Bare Board.SLDPRT
3D CAD Models/10096511.SLDASM
3D CAD Models/10096512.SLDASM
3D CAD Models/10100017.SLDPRT
3D CAD Models/10100018.SLDPRT
3D CAD Models/2004200 Rondelle plate - MN INOX 3 x 8 EP 0.8.sldprt
3D CAD Models/2877500 mousse adhesive 3x20 Légendair.SLDPRT
3D CAD Models/2931200 mousse ép 10mm .SLDPRT
3D CAD Models/2957500 Vis TCB D 3.5 x 8 hexalobes acier zingué.sldprt
3D CAD Models/2957600 Vis TCB D 3.5 x 16 hexalobes acier zingué.sldprt
3D CAD Models/2960100 Vis TCB M3-8 hexalobes acier zingué.sldprt
3D CAD Models/2960600 Vis TF M4 x 10 hexalobes acier zingué.sldprt
3D CAD Models/2961500 Pieds autocollants 12.7x12.7 ep5.8.SLDPRT
3D CAD Models/2963500 batterie legendair.SLDPRT
3D CAD Models/2963800 Vis tête fraisée M3 x 8.SLDPRT
3D CAD Models/2964000 traversée cloison PMC4202.SLDPRT
3D CAD Models/2966100 Vis TCB M3 x 5 exalobes acier zingué .SLDPRT
3D CAD Models/2966300 (ref AML).SLDPRT
3D CAD Models/2970100 goupille cylindrique DIA 2x28.SLDPRT
3D CAD Models/2970300 raccord droit 2.4x3.2 plastique.SLDPRT
3D CAD Models/2970400 Raccord TE 2.4 plastique.SLDPRT
3D CAD Models/2970800 Vis TCB D 3 x 6 hexalobes acier zingué.SLDPRT
3D CAD Models/2970900 vanne A-M O2 FAS.SLDPRT
3D CAD Models/2970999 Vanne A-M O2 FAS.SLDASM
3D CAD Models/2971600 collier adhésif ajustable.SLDPRT
3D CAD Models/2973900 (ref AML).SLDPRT
3D CAD Models/2980100 ferrite 18.8x28.5x13.2.SLDPRT
3D CAD Models/3804800 Filtre entrée d'air.SLDPRT
3D CAD Models/3808400.SLDASM
3D CAD Models/3808801 support cone expiration legendair.SLDPRT
3D CAD Models/3809700 Bouton moleté imperdable.SLDPRT
3D CAD Models/3810200.SLDPRT
3D CAD Models/3812400 entretoise hexa M-F M3.SLDPRT
3D CAD Models/3812500 tole blindage toron moteur.SLDPRT
3D CAD Models/3814200.SLDPRT
3D CAD Models/3814400 ressort capot.SLDPRT
3D CAD Models/3822000.SLDPRT
3D CAD Models/3822500.SLDASM
3D CAD Models/3822500_WIRES.SLDPRT
3D CAD Models/3823200 exterieur poignée.SLDPRT
3D CAD Models/3823200 intérieure poignée.SLDPRT
3D CAD Models/3823200.sldasm
3D CAD Models/3824300 Assy with labels (ref Assy).SLDASM
3D CAD Models/3824300_Main block.SLDPRT
3D CAD Models/3824300_Plastic Insert.SLDPRT
3D CAD Models/3825500.SLDPRT
3D CAD Models/3825700 étiq éxpiration usage unique.SLDPRT
3D CAD Models/3826102 étiquette rappel alarme.SLDPRT
3D CAD Models/3826300 étiquette ATTENTION SECTEUR.SLDPRT
3D CAD Models/3827900.SLDPRT
3D CAD Models/3828200 etiq ident caisson turbine.SLDPRT
3D CAD Models/3828200.SLDPRT
3D CAD Models/3828299 REF ASSY (INCLUDES FOAM).SLDASM
3D CAD Models/3828703 étiquette US o2.SLDPRT
3D CAD Models/3828800 etiq entrée d'air symbolisée.SLDPRT
3D CAD Models/3838600 etiq ID+code barre revB.SLDPRT
3D CAD Models/3838600 étiquette traçabilité .SLDPRT
3D CAD Models/3838600.SLDPRT
3D CAD Models/3839402 etiq sortie d'air symbolisée.SLDPRT
3D CAD Models/3839403 étiquette connexion valve.sldprt
3D CAD Models/3845900_ferrite tube plat 1,3x6,5 prof10 larg 40.SLDPRT
3D CAD Models/3846100.SLDASM
3D CAD Models/3846100_Cable.SLDPRT
3D CAD Models/4096600 étiquette identification XL2.SLDPRT
3D CAD Models/4096600.M00.023 boitier capteur debit.SLDPRT
3D CAD Models/43650-0224.SLDPRT
3D CAD Models/60601-1 Test Finger.SLDPRT
3D CAD Models/90151-2110.SLDPRT
3D CAD Models/901700010 avec patte.SLDPRT
3D CAD Models/90635-1102 +90170-0010 molex avec patte.SLDASM
3D CAD Models/90635-1102.SLDPRT
3D CAD Models/valve chiprop .SLDPRT
BOM Drawings/PB560 PowerPack/10106052C00/10106052.SLDASM
BOM Drawings/PB560 PowerPack/10106052C00/10106052_Batt GND Contact.SLDPRT
BOM Drawings/PB560 PowerPack/10106052C00/10106052_Batt contact 2pin pogo.SLDPRT
BOM Drawings/PB560 PowerPack/10106052C00/10106052_EMI Suppressor.sldprt
BOM Drawings/PB560 PowerPack/10106052C00/10106052_Relay.SLDPRT
BOM Drawings/PB560 PowerPack/10106052C00/10106054.SLDPRT
BOM Drawings/PB560 PowerPack/10106052C00/3838600 REF.SLDPRT
BOM Drawings/PB560 PowerPack/10106052C00/5220719601.sldprt
BOM Drawings/PB560 PowerPack/10106052C00/5220719602.sldprt
BOM Drawings/PB560 PowerPack/10106052C00/5220719603.sldprt
BOM Drawings/PB560 PowerPack/10106054A00/10106054.SLDDRW
BOM Drawings/PB560 PowerPack/10109797A00/009508020.SLDPRT
BOM Drawings/PB560 PowerPack/10109797A00/10109797 Flat Wire.SLDPRT
BOM Drawings/PB560 PowerPack/10109797A00/10109797.SLDASM
BOM Drawings/PB560 PowerPack/10109797A00/10109797.SLDDRW
BOM Drawings/PB560 PowerPack/10109799A00/10109799 flat_wire.SLDPRT
BOM Drawings/PB560 PowerPack/10109799A00/10109799.SLDASM
BOM Drawings/PB560 PowerPack/10109799A00/10109799.SLDDRW
BOM Drawings/PB560 PowerPack/10109800A00/009501031 Plug to charger.SLDPRT
BOM Drawings/PB560 PowerPack/10109800A00/10109800 Heatshrink.SLDPRT
BOM Drawings/PB560 PowerPack/10109800A00/10109800 wire_flat.SLDPRT
BOM Drawings/PB560 PowerPack/10109800A00/10109800.SLDASM
BOM Drawings/PB560 PowerPack/10109800A00/10109800.SLDDRW
BOM Drawings/PB560 PowerPack/10109801A00/10109801 DC Conn overmold.SLDPRT
BOM Drawings/PB560 PowerPack/10109801A00/10109801.SLDASM
BOM Drawings/PB560 PowerPack/10109801A00/10109801.SLDDRW
BOM Drawings/PB560 PowerPack/10109801A00/10109801_Flat Wire.SLDPRT
BOM Drawings/PB560 PowerPack/10109801A00/436450200.SLDPRT
BOM Drawings/PB560 PowerPack/10109801A00/Nut 7 16-32_Switchcraft L712AS.SLDPRT
BOM Drawings/PB560 PowerPack/10109801A00/Washer_Switchcraft L712AS.SLDPRT
BOM Drawings/PB560 PowerPack/10109802B00/10109802.SLDASM
BOM Drawings/PB560 PowerPack/10109802B00/10109802.SLDDRW
BOM Drawings/PB560 PowerPack/10109802B00/10109802_DC Plug Assy.SLDASM
BOM Drawings/PB560 PowerPack/10109802B00/10109802_Ferrite Overmold.SLDPRT
BOM Drawings/PB560 PowerPack/10109802B00/10109802_HS Label L35.SLDPRT
BOM Drawings/PB560 PowerPack/10109802B00/10109802_Switchcraft 761KS15 slotted Assy.SLDASM
BOM Drawings/PB560 PowerPack/10109802B00/10109802_Switchcraft plug overmold.SLDPRT
BOM Drawings/PB560 PowerPack/10109802B00/10109802_Switchcraft plug premold.SLDPRT
BOM Drawings/PB560 PowerPack/10109802B00/10109802_cable.SLDPRT
BOM Drawings/PB560 PowerPack/10109802B00/10109802_routed cable.SLDPRT
BOM Drawings/PB560 PowerPack/10110230A00 (1)/10110230.SLDASM
BOM Drawings/PB560 PowerPack/10110230A00 (1)/10110230_Glue_Loctite_460.SLDPRT
BOM Drawings/PB560 PowerPack/10110230A00 (1)/10130877.SLDPRT
BOM Drawings/PB560 PowerPack/10110230A00 (1)/3843200.SLDPRT
BOM Drawings/PB560 PowerPack/10110232A00/10110232 (plastic only).SLDPRT
BOM Drawings/PB560 PowerPack/10110232A00/10110232.SLDASM
BOM Drawings/PB560 PowerPack/10110232A00/10110232.SLDDRW
BOM Drawings/PB560 PowerPack/10110232A00/10110232.SLDPRT
BOM Drawings/PB560 PowerPack/10110232A00/2558600.SLDPRT
BOM Drawings/PB560 PowerPack/10113688A00/10113688 Flat_wire.SLDPRT
BOM Drawings/PB560 PowerPack/10113688A00/10113688.SLDASM
BOM Drawings/PB560 PowerPack/10113688A00/10113688.SLDDRW
BOM Drawings/PB560 PowerPack/10123460A00/10123460.SLDDRW
BOM Drawings/PB560 PowerPack/10123460A00/10123460.SLDPRT
BOM Drawings/PB560 PowerPack/10123460A00/3822800.SLDPRT
BOM Drawings/PB560 PowerPack/10128169B00/10128169.SLDASM
BOM Drawings/PB560 PowerPack/10128169B00/10128169.slddrw
BOM Drawings/PB560 PowerPack/10128169B00/10128169_BASE.SLDPRT
BOM Drawings/PB560 PowerPack/10128169B00/10128169_BOX.SLDPRT
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
