ac-ctrl/Medtronic-PB560-Ventilator-System/Purchased Part Drawings/2980100/2970500F00.pdf

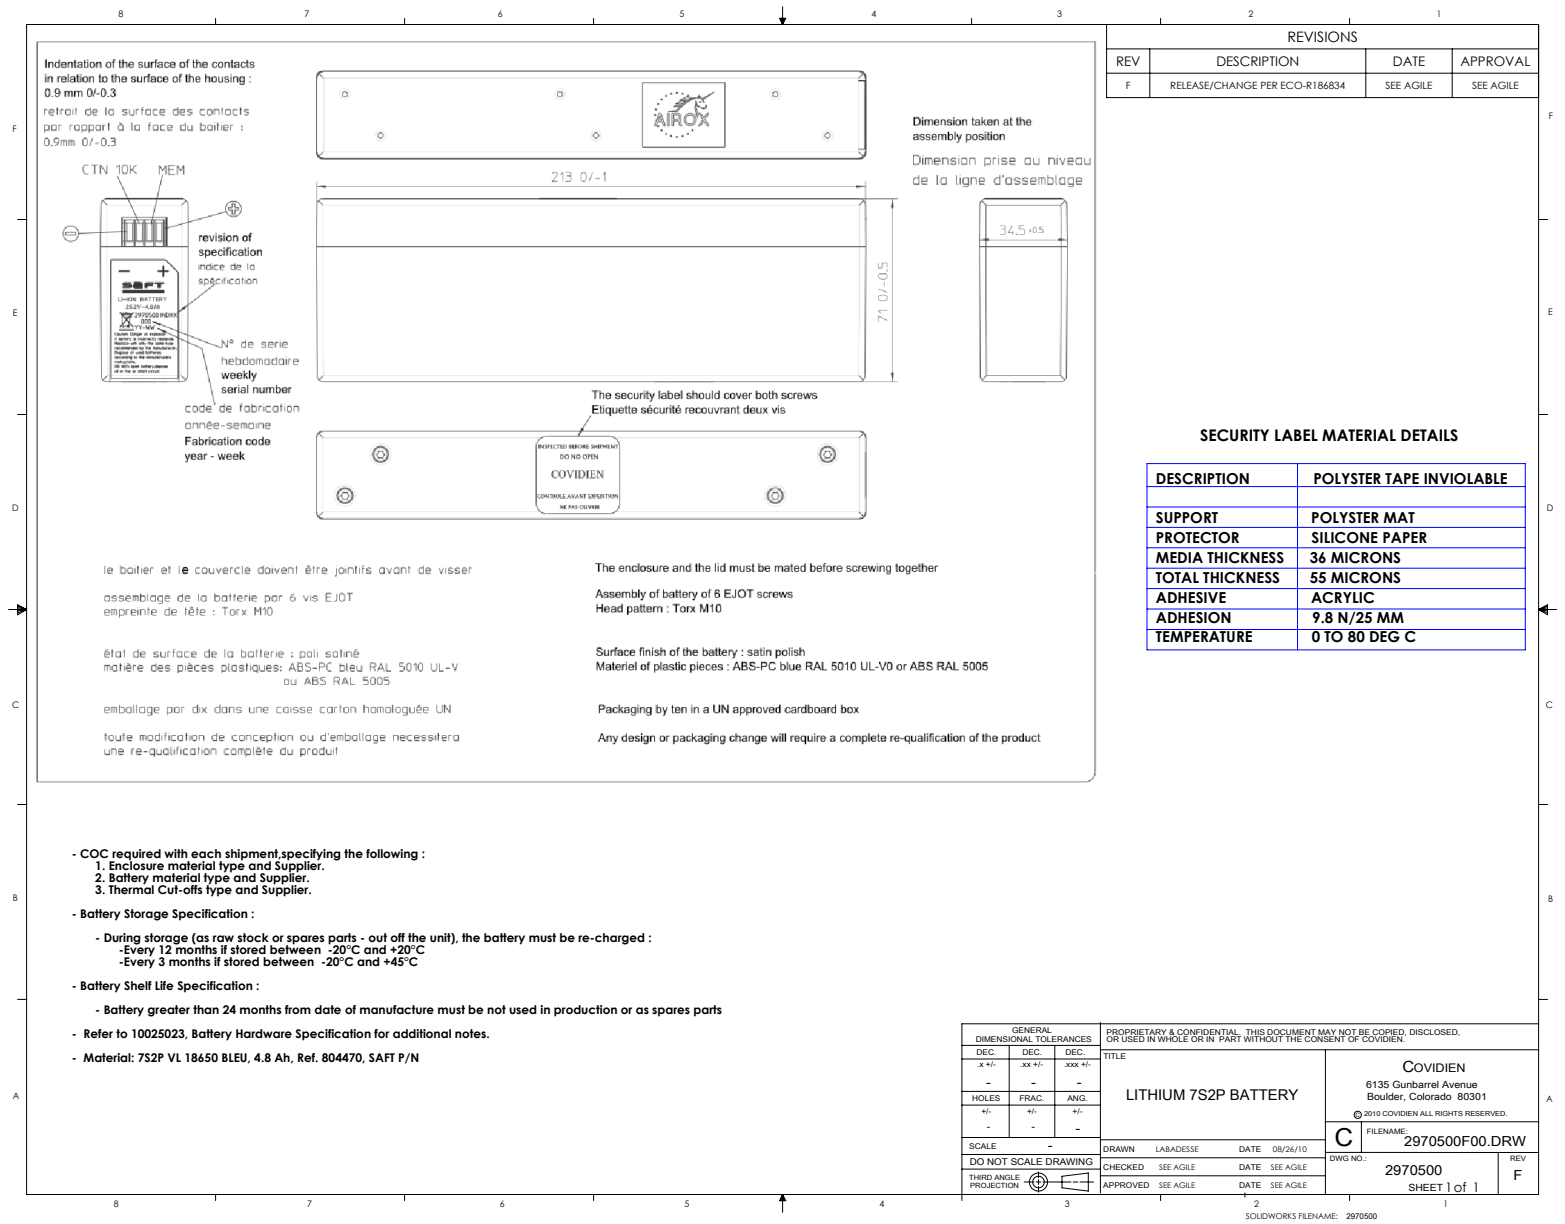
[picture p126: page 1]
DESCRIPTION; POLYSTER TAPE INVIOLABLE; .xxx +/-; DIMENSIONAL TOLERANCES; DWG NO.:; 6135 Gunbarrel Avenue Boulder, Colorado 80301; SEE AGILE; SOLIDWORKS FILENAME: 2970500

REV | DESCRIPTION | DATE | APPROVAL

F | RELEASE/CHANGE PER ECO-R186834 | SEE AGILE | SEE AGILE

SECURITY LABEL MATERIAL DETAILS

SUPPORT | POLYSTER MAT
PROTECTOR | SILICONE PAPER
MEDIA THICKNESS | 36 MICRONS
TOTAL THICKNESS | 55 MICRONS
ADHESIVE | ACRYLIC
ADHESION | 9.8 N/25 MM
TEMPERATURE | 0 TO 80 DEG C

- COC required with each shipment,specifying the following :
1. Enclosure material type and Supplier.
2. Battery material type and Supplier.
3. Thermal Cut-offs type and Supplier.
- Battery Storage Specification :
- During storage (as raw stock or spares parts - out off the unit), the battery must be re-charged :
-Every 12 months if stored between -20°C and +20°C
-Every 3 months if stored between -20°C and +45°C
- Battery Shelf Life Specification :
- Battery greater than 24 months from date of manufacture must be not used in production or as spares parts
- Refer to 10025023, Battery Hardware Specification for additional notes.
- Material: 7S2P VL 18650 BLEU, 4.8 Ah, Ref. 804470, SAFT P/N

PROPRIETARY & CONFIDENTIAL. THIS DOCUMENT MAY NOT BE COPIED, DISCLOSED,
OR USED IN WHOLE OR IN PART WITHOUT THE CONSENT OF COVIDIEN.
TITLE
LITHIUM 7S2P BATTERY

C 2010 COVIDIEN ALL RIGHTS RESERVED.
FILENAME:
2970500F00.DRW

SCALE
DO NOT SCALE DRAWING
THIRD ANGLE
