ac-ctrl/Medtronic-PB560-Ventilator-System/Purchased Part Drawings/3822500/3822500C00.PDF

| REVISIONS
4 | 3 | 2 | 1

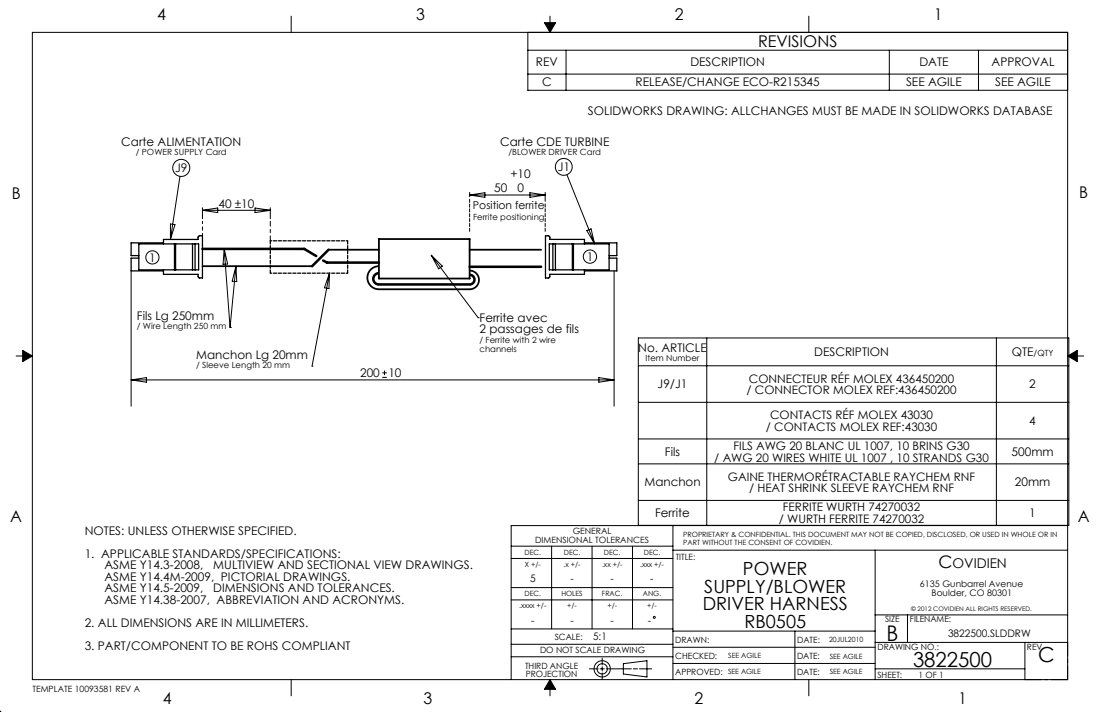
[picture p127: page 1]
2 TEMPLATE 10093581 REV A; .xxxx +/-; DEC.; THIRD ANGLE PROJECTION; HOLES; FRAC.; ANG.; .xxx +/-; SHEET:; DATE:; DRAWING NO.:

REV | DESCRIPTION | DATE | APPROVAL
C | RELEASE/CHANGE ECO-R215345 | SEE AGILE | SEE AGILE

SOLIDWORKS DRAWING: ALLCHANGES MUST BE MADE IN SOLIDWORKS DATABASE

Carte ALIMENTATION
/ POWER SUPPLY Card

Carte CDE TURBINE
/BLOWER DRIVER Card
Position ferrite
Ferrite positioning

Fils Lg 250mm
/ Wire Length 250 mm

Ferrite avec
2 passages de fils
/ Ferrite with 2 wire
channels

No. ARTICLE Item Number | DESCRIPTION | QTE/QTY

Manchon Lg 20mm
/ Sleeve Length 20 mm

J9/J1 | CONNECTEUR RÉF MOLEX 436450200 / CONNECTOR MOLEX REF:436450200 | 2

CONTACTS RÉF MOLEX 43030 / CONTACTS MOLEX REF:43030 | 4

Fils | FILS AWG 20 BLANC UL 1007, 10 BRINS G30 / AWG 20 WIRES WHITE UL 1007 , 10 STRANDS G30 | 500mm
Manchon | GAINE THERMORÉTRACTABLE RAYCHEM RNF / HEAT SHRINK SLEEVE RAYCHEM RNF | 20mm
Ferrite | FERRITE WURTH 74270032 / WURTH FERRITE 74270032 | 1

NOTES: UNLESS OTHERWISE SPECIFIED.
1. APPLICABLE STANDARDS/SPECIFICATIONS:
ASME Y14.3-2008, MULTIVIEW AND SECTIONAL VIEW DRAWINGS.
ASME Y14.4M-2009, PICTORIAL DRAWINGS.
ASME Y14.5-2009, DIMENSIONS AND TOLERANCES.
ASME Y14.38-2007, ABBREVIATION AND ACRONYMS.
2. ALL DIMENSIONS ARE IN MILLIMETERS.
3. PART/COMPONENT TO BE ROHS COMPLIANT

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

TITLE: POWER SUPPLY/BLOWER DRIVER HARNESS RB0505 | COVIDIEN 6135 Gunbarrel Avenue Boulder, CO 80301 © 2012 COVIDIEN ALL RIGHTS RESERVED. B ⁻

SIZE | FILENAME: 3822500.SLDDRW 20JUL2010

5:1 SCALE: | DRAWN: CHECKED: SEE AGILE APPROVED: SEE AGILE | DATE: SEE AGILE
DO NOT SCALE DRAWING | | | 3822500 | REV C
