ac-ctrl/Medtronic-PB560-Ventilator-System/(list of files, drawings)

Other design files:
BOM Drawings/PB560 PowerPack/10105965B00/10105965B00.DSN
BOM Drawings/PB560 PowerPack/10107738A00/10106054A00.pcb
