ac-ctrl/Medtronic-PB560-Ventilator-System/(commit log)

2020-03-31 Add Release 2.0
    [039281023.SLDPRT, 09-48-4038.SLDPRT, 09-48-4128.SLDPRT, 10021741_A.dwg, 10021744 Approved Revision A.dwg, 10025172 A00.dwg, 10049560_Fan Assy (ref ASM).SLDASM, 10049560_Routed wires (asm ref Part).SLDPRT]
2020-04-08 Add Release 4.0 and 5.0
    [009501031 Plug to charger.SLDPRT, 009508020.SLDPRT, 10037183W00.xlsx, 10037310U00.xlsx, 10038091B0100.dwg, 10038094B0100.dwg, 10038095A0100.dwg, 10038096A0100.dwg]
